CrazyWizard-png/Crazy-75__Custom-Mechanical-Keyboard/README.md

# Crazy-75
The journey of creating my first ever custom mechanical keyboard. 

Check my journal for the newest progress updates.
