CrazyWizard-png/Crazy-75__Custom-Mechanical-Keyboard/images/Pi pico clone pinout.png

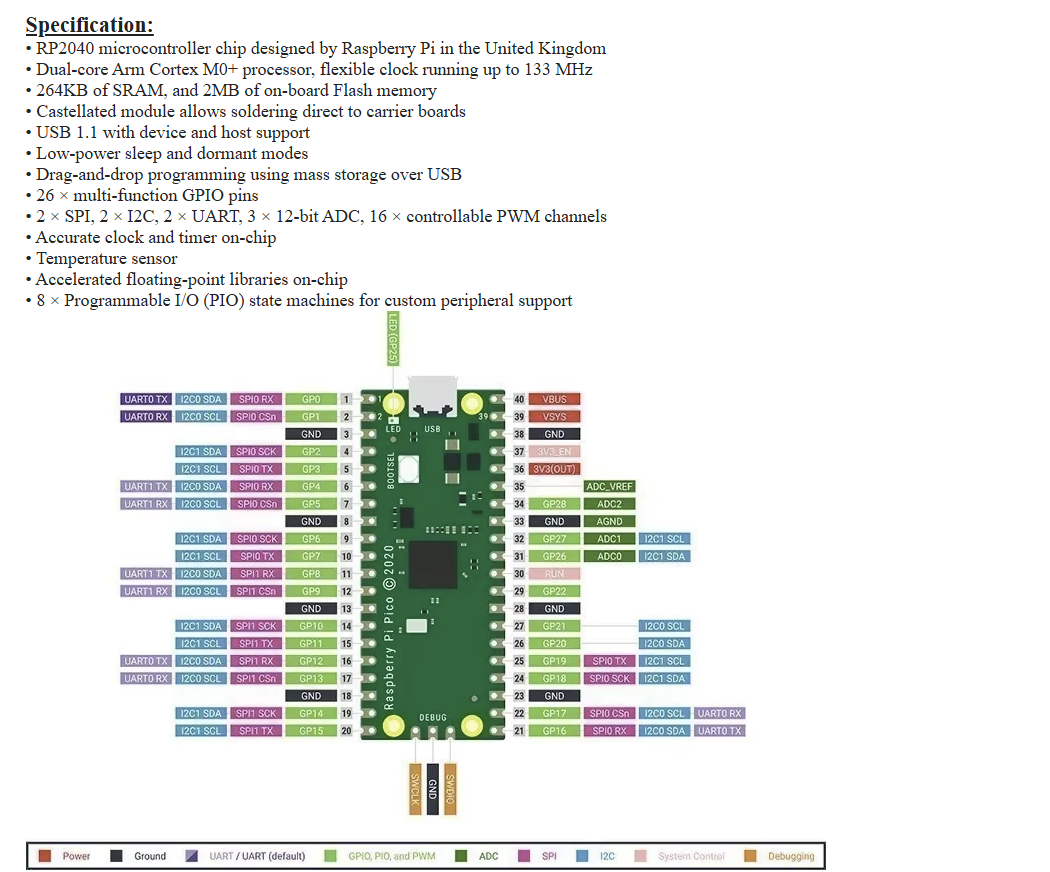
images/Pi pico clone pinout.png
