CrazyWizard-png/Crazy-75__Custom-Mechanical-Keyboard/Keyboard BOM.xlsx

Part No. | Name | Description | Quantity required | Quantity | Total (EURO) | Link | .
1 | Kailh Hot-swappable PCB socket | Kailh style Hot-swappable PCB socket Hot Plug CPG151101S11 for Gateron Outemu Cherry MX Switches Mechanical Keyboard | 78 | 80 | 14.04 | https://42keebs.eu/shop/parts/kailh-mx-hot-swap-sockets/ | .
2 | Switches |  | 78 |  |  |  | .
3 | Keycaps |  | 79 |  |  |  | .
4 | 1N4148 High-speed Switching Diodes |  | 79 | 80 | 1.72 | https://fr.aliexpress.com/item/4001126137167.html?curPageLogUid=NsA9XtVVd8ar (https://42keebs.eu/shop/parts/components/1n4148-diodes-through-hole-smd/?attribute_type=Through-hole) | .
5 | SK6812 MINI-E RGB |  | 80 | 100 | 4.99 | https://fr.aliexpress.com/item/1005007863635868.html?curPageLogUid=OsdDD2ovEBL6 | .
6 | EC11 rotary encoder | 360 Degree Rotary Encoder EC11 With Push Button | 1 | 1 | 1.99 | https://fr.aliexpress.com/item/1005007644083514.html?curPageLogUid=RiI44SzlN0mT | .
7 | Frood RP2040 Pro Micro Controller |  | 1 | 1 | 12.87 | https://42keebs.eu/shop/parts/controllers/frood-rp2040-pro-micro-controller/ | .
8 | Stabilizers | Screw-in scabilizers | 6.25u & 3x2u | 6.25u & 4x2u | 24.07 | https://fr.aliexpress.com/item/1005001632672798.html?curPageLogUid=chUJ3H275Bvb | .
9 |  |  |  |  |  |  | .
10 | Fine tweezers | straight and curved fine tweezers | 1 | 1 | 2.17 | https://fr.aliexpress.com/item/1005005589349988.html?browser_id=2269fcae49994bc495ac18d9a18a9643 | .
11 | USB cable |  |  |  |  |  | .
12 | Quality solder |  |  |  |  |  | .
13 | Poron Gaskets strips | 90x5x2mm | 4 | 5 | 3.91 | https://fr.aliexpress.com/item/1005005793344984.html?curPageLogUid=S7v4FRbEFjS1 | .
14 | Poron gasket PCB switch pads |  | 78 | 120 | 3.21 | https://fr.aliexpress.com/item/1005012165183655.html?curPageLogUid=HxhioEm1eLyc | .
15 | Poron gasket plate pads |  | 78 | 120 | 3.6 | https://fr.aliexpress.com/item/1005011957195138.html?curPageLogUid=zxNyBwnBzLWJ | .
16 | M3 Heat Set inserts | 400pc kit | 8 |  | 10.4 | https://fr.aliexpress.com/item/1005005789416899.html?curPageLogUid=npJ5GAaoLiBK | .
17 | M3 machine screws | Already owned |  |  |  |  | .
18 | Pinecil heat set inserts kit |  |  |  | 32.35 | https://keeb.supply/products/pinecil-threaded-insert-tips-set | .
19 | Self adhesive silicon rubber feet | 10x3mm | 6 | 20 | 3.1 | https://fr.aliexpress.com/item/1005006612644612.html?curPageLogUid=zZGnjd4BE3HC | .
 |  |  |  |  |  |  | .
 |  |  |  |  |  |  | .
 |  |  |  |  |  |  | .
 | Total |  |  |  | 111.61 |  | .
