CrazyWizard-png/Crazy-75__Custom-Mechanical-Keyboard/CAD/Crazy-75 - PCB.step

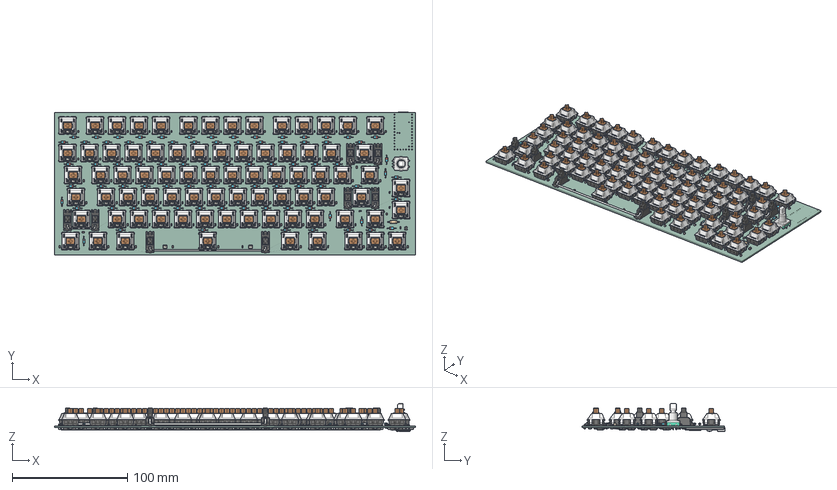
[picture p2: CAD file, 2026-10-01]
CAD/Crazy-75 - PCB.step
313.0 x 123.8 x 24.7 mm
C_0805_2012Metric x 82
D_DO-35_SOD27_P7.62mm_Horizontal x 80
Stabilizer_Cherry_MX_6_25u_cp
SOT-23-5
Stabilizer_Cherry_MX_2u_cp x 3
R_Axial_DIN0207_L63mm_D25mm_P1016mm_Horizontal
EC11N1525404 v3
Contact x 158
SW_Cherry_MX_Plate_cp x 79
LED_SK6812MINI-E v2 x 81
ProMicroRP2040 - 3D v15
Crazy-75_PCB
