CrazyWizard-png/Crazy-75__Custom-Mechanical-Keyboard/PCB/Crazy-75/Crazy-75 - PCB.step

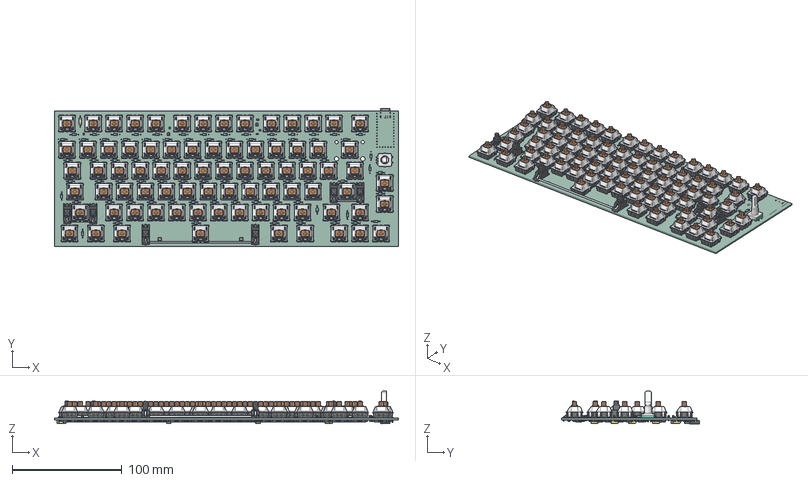
[picture p3: CAD file, 2026-11-01]
PCB/Crazy-75/Crazy-75 - PCB.step
313.0 x 126.0 x 29.6 mm
SOT-23-5
D_DO-35_SOD27_P7.62mm_Horizontal x 80
SOT-23-6 x 3
Stabilizer_Cherry_MX_6_25u_cp
R_0805_2012Metric x 8
Stabilizer_Cherry_MX_2u_cp x 2
C_0805_2012Metric x 85
R_Axial_DIN0207_L63mm_D25mm_P1016mm_Horizontal
(Unsaved)
Contact x 158
SW_Cherry_MX_Plate_cp x 79
LED_SK6812MINI-E v2 x 81
CP_EIA_7343_31_Kemet_D x 9
SOT-23
USB_C_Receptacle_GCT_USB4085
Crazy-75_PCB
