CrazyWizard-png/Crazy-75__Custom-Mechanical-Keyboard/Journal.md

# 1 November 2026 - Updating the USB-C cutout

**Time spent: 1 h**

### What I did

Redid the USB-C cutout in the case CAD model to match the new connector.

### Next step

Start routing the PCB.

---

# 31 October 2026 - Cleaning up the BOM

**Time spent: 1 h 30 min**

### What I did

Finally went through the whole BOM, checked the links, updated prices and compared ordering from AliExpress or 42. Keebs. I had been putting this off for a while because I knew the BOM was a mess.

The hardware currently comes to about **€111**, excluding switches, keycaps and a USB cable. Anything added later will increase that, so hopefully there won't be much left to add since want to keep the costs down.

### Next steps

Redo the USB-C cutout in the case to match the new connector, then start routing the PCB.

---

# 30 October 2026 - PCB component placement

**Time spent: 1 h 15 min**

### What I did

Placed the newly added components in the PCB editor and checked their positions against the case to avoid collisions once everything is assembled.

I caught a few things along the way. The per-key LEDs will be soldered underneath the PCB, but I had placed their SMD capacitors on top. I moved all of those capacitors to the underside too, which should save a lot of unnecessary vias when routing.

I also checked component heights and fixed the silkscreen overlaps that needed attention.

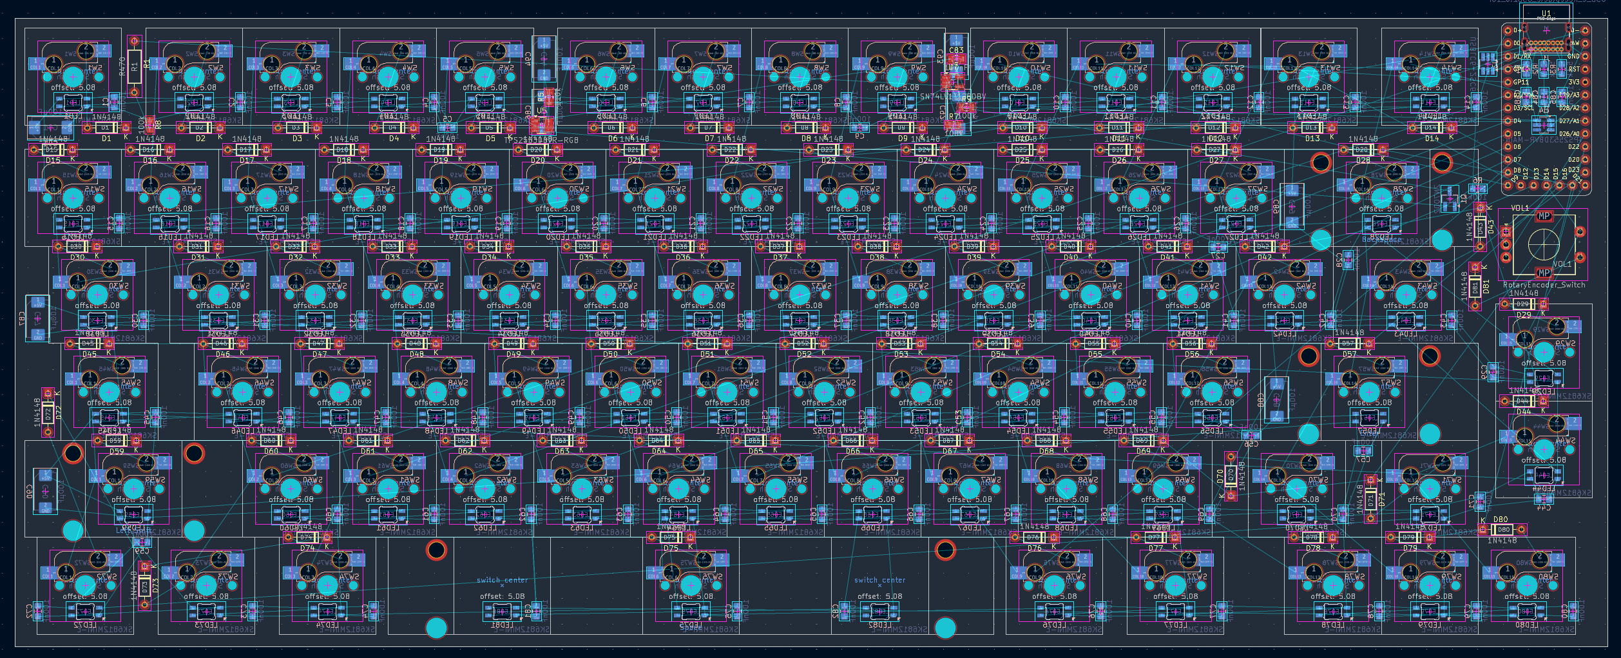
[picture p4: images/PCB-editor_30.10.2026.png]
PCB-editor_30.10.2026

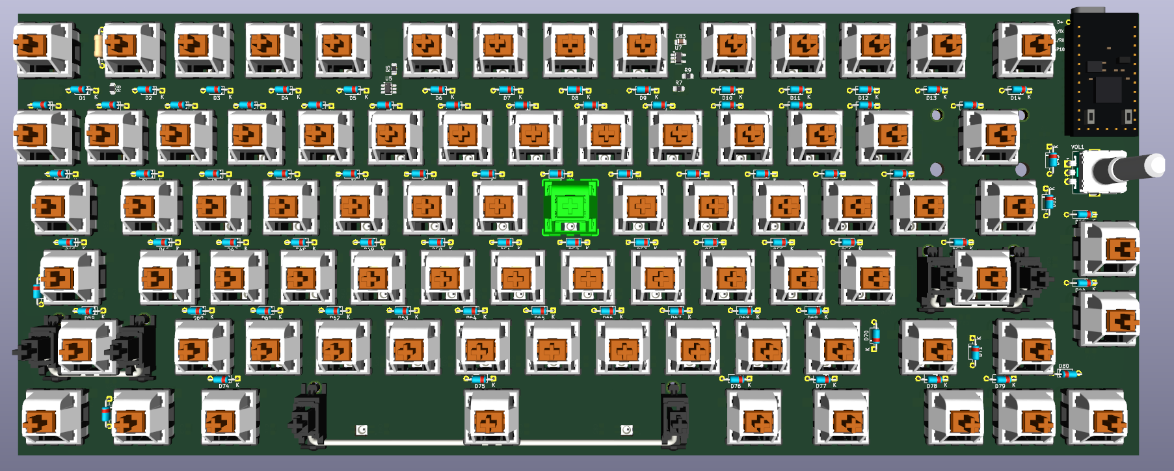
[picture p5: images/PCB-3D-view_front_31.10.2026.png]
PCB-3D-view_front_31.10.2026

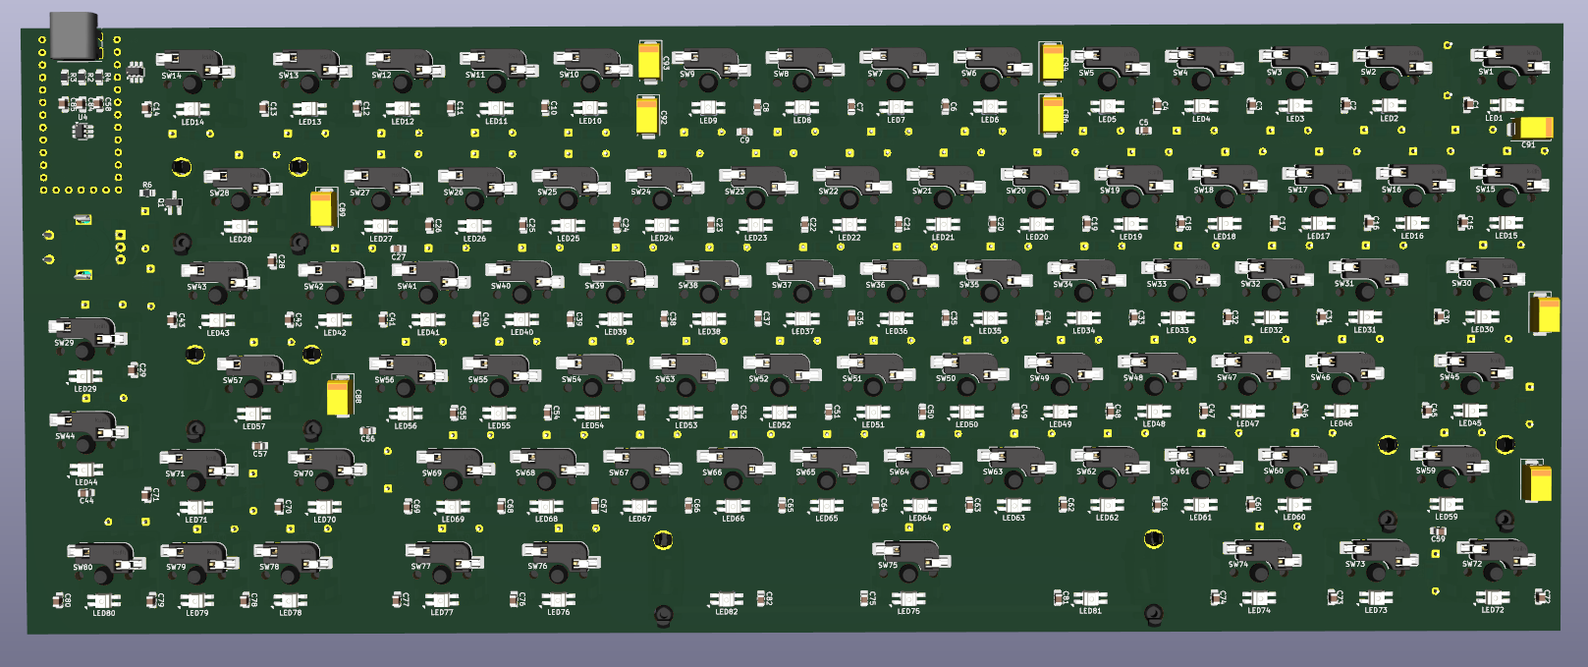
[picture p6: images/PCB-3D-view_back_31.10.2026.png]
PCB-3D-view_back_31.10.2026


---

# 24 October 2026 - Reworking USB and RGB power

**Time spent: 2 h 30 min**

### Schematic changes

Today I added a separate USB-C connector and changed the controller to the **Frood RP2040**. I added USB protection and two current-limited power switches: one for the entire keyboard and one only for the RGB LEDs.

I spent quite a while understanding the circuit instead of just copying setups from the internet. This feels embarrassing since I decided to embark on the journey to create a custom mechanical keyboard from the ground up, but, for example, today I learned the true purpose of Pull-up and pull-down resistors which now finally make more sense, including why the buffer needs a high signal to disable its output.

I decided on a 500 mA power budget which is the the max. current available through conventional USB2.0 ports. And since I only want a gentle glow in the dark, running every LED at full brightness is unnecessary. All the LEDs together could draw several amps, that is why they got their own power limiting switch inside the already power-limited network.

The case has roughly 6 mm underneath the PCB, so I chose low-profile capacitors instead of the tall electrolytic ones. I also selected hand-solder footprints wherever I could, hopefully making life easier for future me.

ERC found no warnings.

#### The reason for this change?

I could not reliably verify the max. current which I could pass through the previously used **TENSTAR RP2040 Pro Micro** and it was bothering me a lot. So I decided to get rid of it and use a module which allows me to install a separate USB-C receptacle and connect the data and power pins to it without having to pass the whole 0.5A through it. 

### Next step

Update the PCB from the schematic, arrange the newly added components and check component placement against the case before routing.

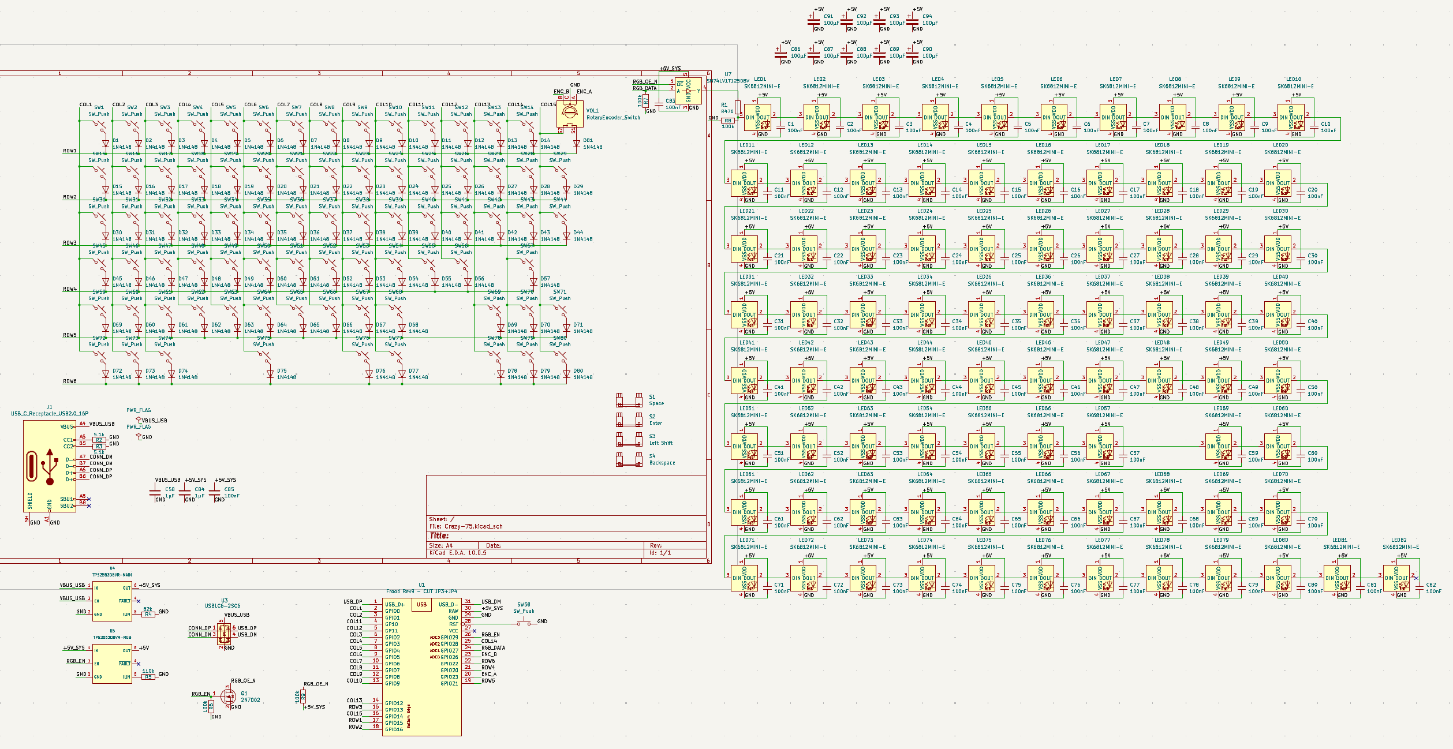
[picture p7: images/24.10.2026_PCB-schematic-rework.png]
PCB-schematic-rework


---

# 10 October 2026 - Preparing for PCB routing

**Time spent: 1 h**

### Researching PCB routing and manufacturing requirements

Today I started preparing for the PCB routing stage of Crazy-75.

Before connecting hundreds of components, I wanted to make sure the PCB design rules were based on actual manufacturing capabilities rather than arbitrary values.

I researched PCBWay's manufacturing specifications, including minimum trace widths, copper clearances, via dimensions, board thickness and copper weight.

I also compared 1 oz and 2 oz copper due to the large amount of LEDs on the board, ultimately leaning towards 1 oz because it offers sufficient flexibility for the densely populated keyboard PCB, provided the power distribution is designed appropriately.

### Configuring KiCad and troubleshooting DRC

I began configuring KiCad's design rules and ran the Design Rules Checker (DRC).

This initially produced numerous copper-to-edge clearance errors around the SK6812 MINI-E RGB LEDs. The reported distances also changed as I adjusted the minimum clearance, which made the problem confusing to diagnose.

After researching PCBWay's manufacturing tolerances, I changed the minimum copper-to-edge clearance to **0.25 mm**, matching their published normal-process specification. This eliminated the reported errors.

### Investigating power limitations

Another important question was how much current the keyboard can safely draw through its **TENSTAR RP2040 Pro Micro 16MB** development board.

With approximately 81 individually addressable RGB LEDs, the power supply could become a significant limitation.

I researched USB power limits and the development board's specifications, but could not find reliable documentation confirming the maximum current that can pass from its USB-C connector to the 5V pin.

I therefore contacted TENSTAR 02 Store by email, requesting information about the maximum continuous output current, USB power-path components, USB-C configuration and any available schematics.

### Investigating autorouting

Given the large number of connections, I also investigated alternatives to manually routing the entire PCB.

I decided to try **Freerouting**, an open-source autorouter compatible with KiCad, and installed its plugin.

The current plan is to use autorouting for most of the switch matrix and signal connections while paying particular attention to the 5V power distribution, grounding and RGB LED circuitry.

### Current state and next steps

The PCB routing rules have been partially configured, the initial DRC errors have been resolved, and Freerouting is installed.

I am now waiting for technical information from two sources:

- **TENSTAR:** USB power-path specifications and safe current limits.
    
- **PCBWay:** Engineering advice on the SLS PA12 switch plate openings and confirmation of manufacturing details.

**Next step:** Test Freerouting on a separate copy of the PCB, evaluate the resulting connections and continue refining the design rules as the manufacturers provide more information.

_Time spent watching KiCad tutorials on YouTube is not included in the recorded hour._

---

# 9 October 2026 - Finishing the functional case design

**Time spent: 1 h 30 min**

### Finishing the case mounting system

Today I completed the remaining functional details of the Crazy-75 enclosure.

I added the mounting holes for the screws connecting the top and bottom case halves. The design uses eight screw positions, with M3 heat-set inserts planned for the top case. These will allow the case to be opened repeatedly without wearing out threads in the printed plastic.

I also added six locations for adhesive rubber feet on the underside of the case, arranged in two rows of three to provide stable support across the keyboard.

### More Fusion problems

Fusion caused further problems today. When attempting to launch it, I was presented with several error messages, and the application would not start properly.

Restarting the computer did not resolve the issue, and Fusion continued behaving as though parts of the program were still running.

I eventually had to reinstall Fusion to get it working again.

This added more troubleshooting to a project that has already experienced several CAD software problems.

### Current state

The **functional case design is now complete**, including:

- Two-piece enclosure with a 5° typing angle
    
- Openings for the switches and rotary encoder
    
- Gasket mounting geometry
    
- Clearance for the PCB and its components
    
- USB-C access
    
- Eight case screw positions
    
- Six rubber feet locations

I am still waiting for PCBWay's engineering team to recommend suitable dimensional compensation for the 14 × 14 mm switch openings in the SLS PA12 plate.

I have not decided whether to add further aesthetic details to the case. For now, I am satisfied with the functional geometry and would rather continue with the electronics than spend additional time changing its appearance without a clear goal.

**Next step:** Begin routing the PCB in KiCad, followed by electrical and manufacturing checks.

---

# 2 October 2026 - Designing the bottom case

**Time spent: 1 h**

### Starting the bottom enclosure

Today I designed the first functional version of the bottom half of the Crazy-75 case.

Unlike the flat top case, the bottom enclosure is wedge-shaped to create the keyboard's typing angle. I used a **5° typing angle**, making the enclosure progressively taller towards the rear while keeping the top and plate assembly aligned.

I built the bottom around the existing top-case and PCB assembly rather than designing it independently. This made it possible to check the actual space required underneath the PCB and its components.

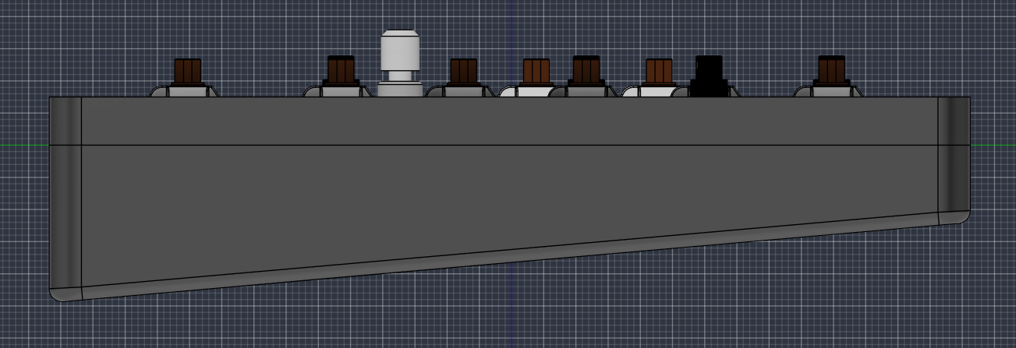
[picture p8: images/Case-bottom-side.png]
Bottom case side view


### Internal clearance and USB-C

The enclosure was sized around the lowest components underneath the PCB while leaving additional clearance between the electronics and the case floor.

I also added the opening for the RP2040's USB-C connector. Moving the controller to the underside and edge of the PCB earlier made this considerably simpler, since the connector can now be accessed directly through the rear of the enclosure.

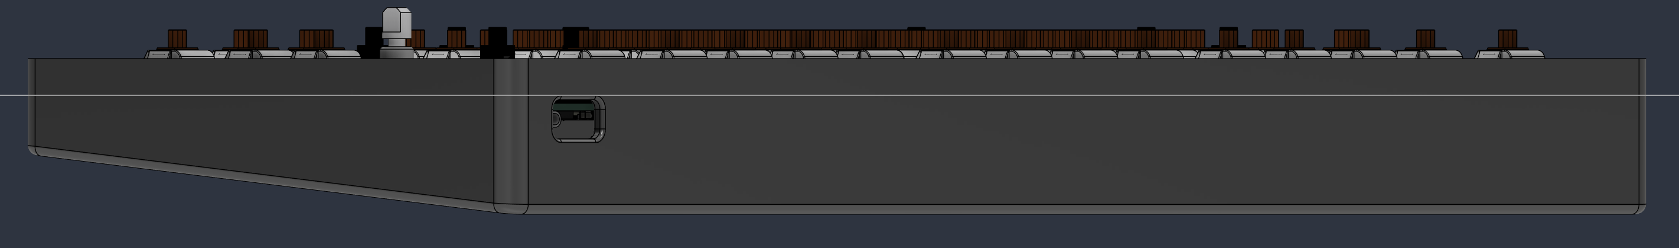
[picture p9: images/Case_bottom-USB-C.png]
USB-C opening


### Fusion problems

A significant part of today's work was spent dealing with Fusion rather than making visible CAD progress.

Some existing components and geometry would not project correctly into new sketches, which made referencing the already completed parts more difficult than expected.

I also had problems with Fusion's cloud/project memory not synchronizing correctly. This caused additional time to be spent checking the model and working around geometry which Fusion was not referencing as expected.

Despite these problems, I was able to finish the basic bottom-case geometry.

### Current state

The Crazy-75 now has both a top and bottom enclosure in CAD.

The bottom case provides the **5° typing angle**, encloses the PCB and underside components, and provides access to the USB-C connector.

The remaining functional case work is mainly the fastening system which will hold the top and bottom halves together. After that, the case should be sufficiently complete to move back to the PCB and begin routing it.

---

# 1 October 2026 - Starting the top case

**Time spent: 2 h**

### Designing the first case part

Today I started designing the actual Crazy-75 case around the plate and PCB assembly.

I decided to split the case into a flat top section and a bottom section which will later create the keyboard's typing angle. This allows the top case to be designed directly around the existing flat plate while leaving the more complicated inclined geometry for the bottom case.

Rather than creating individual openings around every switch, I used one large opening around the main key area. A separate area was kept around the rotary encoder for aesthetics.

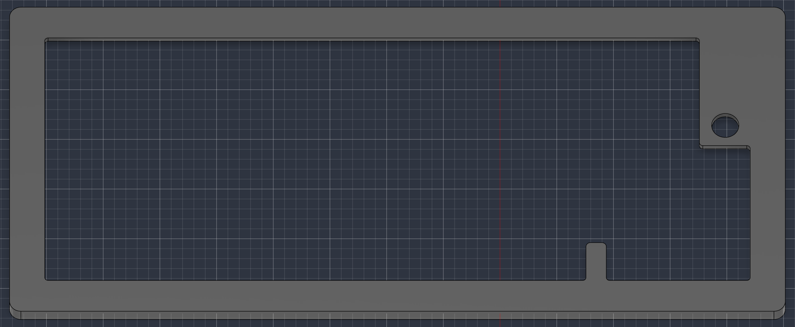
[picture p10: images/Top_case_top-down.png]
Top case


### Plate clearance

I based the internal shape of the top case directly on the existing plate geometry.

I left approximately **0.5 mm nominal clearance between the plate and the rigid top case** around its perimeter. This is important because the plate should eventually be supported through the PORON gaskets rather than resting directly against the case.

The irregular sections of the plate, including the gasket mounting ears and the area around the rotary encoder, were accounted for when creating the opening.

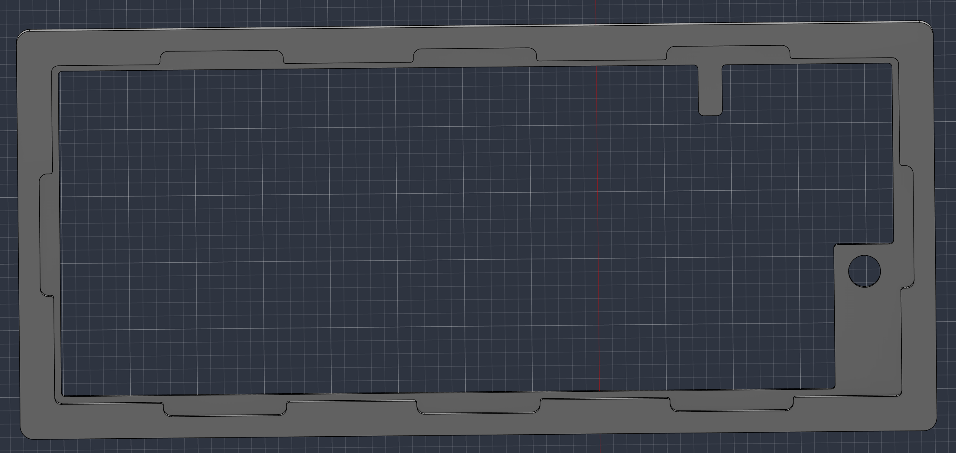
[picture p11: images/Top_case_bottom.png]
Top case bottom


### Gasket mounting

The top case was also designed around the eight gasket locations already present on the plate:

- 3 along the front
- 3 along the rear
- 1 on the left
- 1 on the right

The current plan is to use **45 × 5 × 2 mm PORON gasket strips** at these locations.

The plate and top case geometry now leave the necessary space around these gasket ears so that the plate can eventually be suspended between PORON rather than making rigid contact with the case.

### Checking the assembly

I placed the new top-case geometry together with the existing plate, switches, stabilizers, encoder and PCB assembly in Fusion and visually checked their alignment.

The large opening exposes the switches while the top case surrounds the complete assembly and follows the plate geometry without touching it.

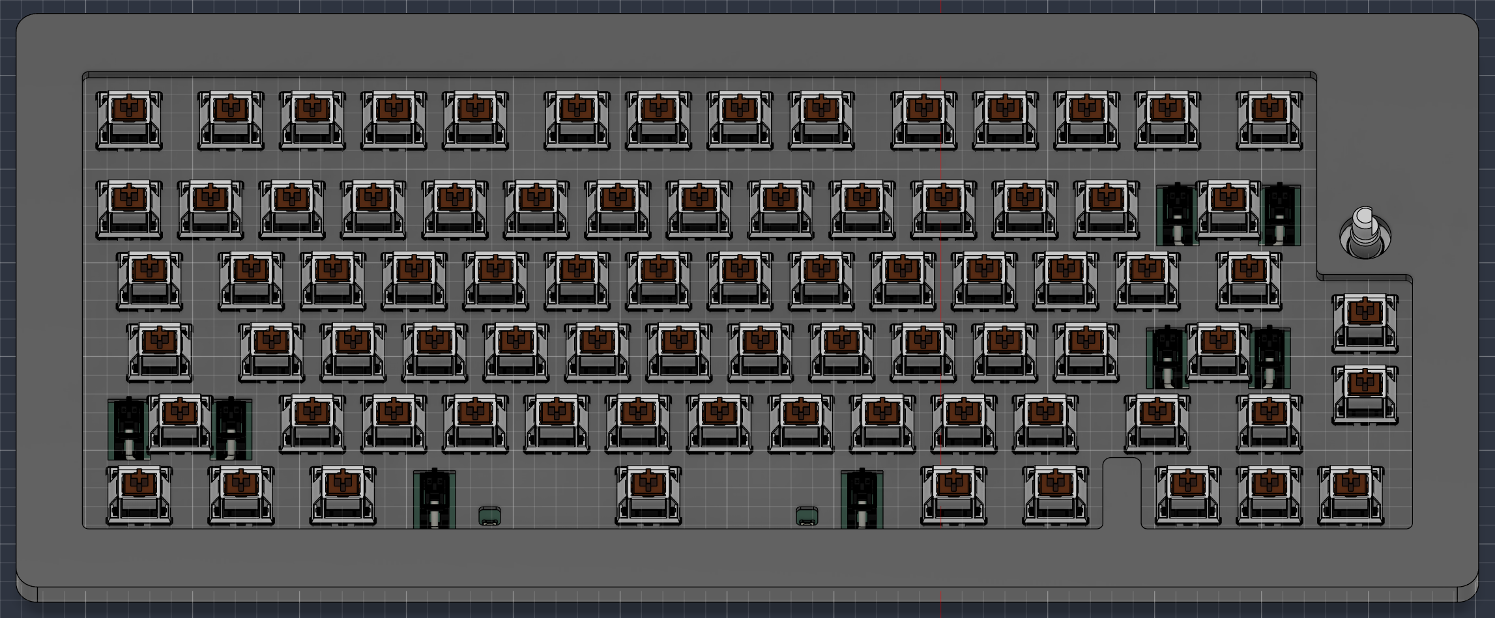
[picture p12: images/Top_case_assembly.png]
Top case assembly


### Current state

The first functional version of the **top half of the Crazy-75 case** now exists.

The bottom case will need to account for:

- the lower gasket supports
- PCB and component clearance
- the RP2040 and USB-C connector
- case screws
- the keyboard's typing angle

---

# 26 September 2026 - Finishing the plate + RP2040 board placement rework

**Time spent: 2 h**

### Finishing the plate

I returned to the plate and added the remaining functional openings.

This took approximately 20 minutes and included:

- clearance cutouts for all four PCB-mounted stabilizers
- two additional openings for the extra LEDs underneath the Spacebar

Because the stabilizers are attached to the PCB rather than the plate, these openings only need to provide sufficient mechanical clearance around their housings.

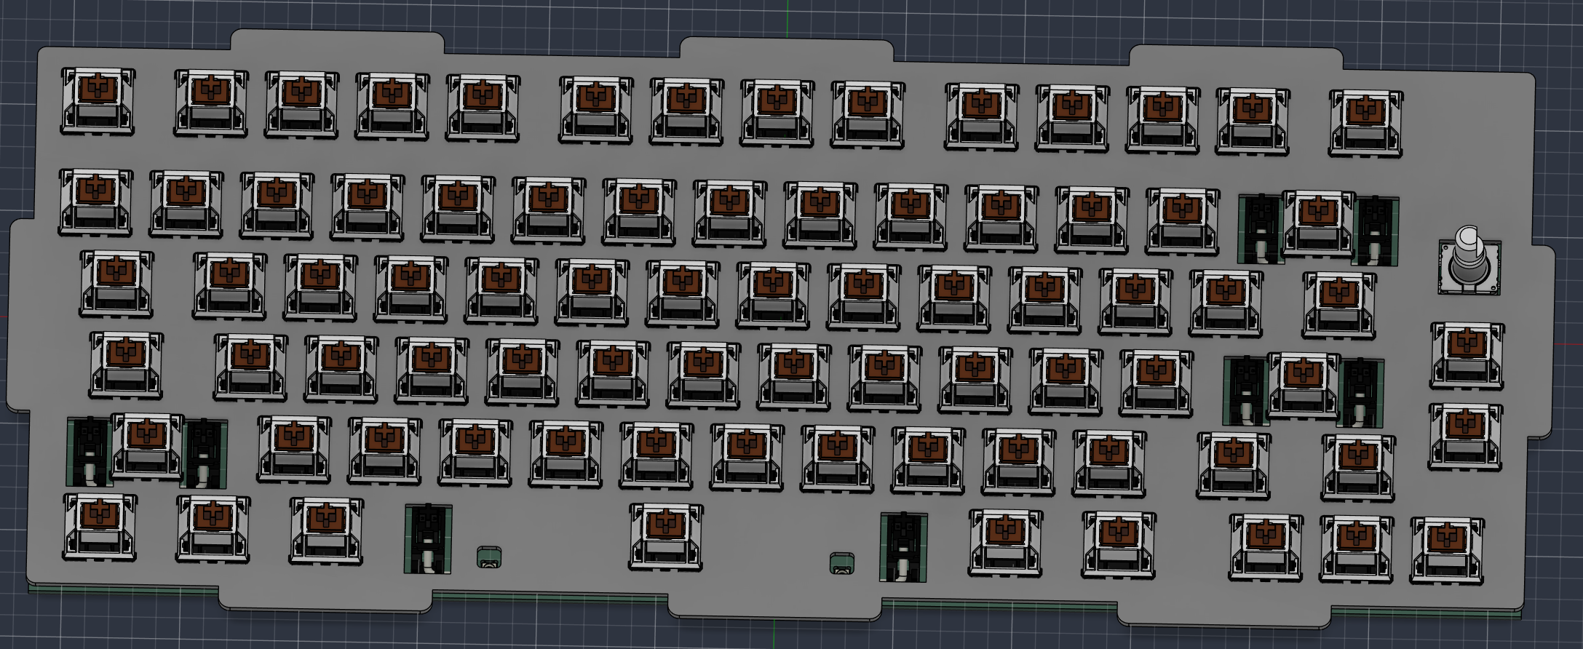
[picture p13: images/26.09.2026-Plate-1.png]
26.09.2026-Plate-1


### Reconsidering the RP2040 mounting

While beginning to think about the actual case around the completed PCB/plate assembly, I realized that the existing RP2040 mounting arrangement created an awkward USB-C problem.

The controller was previously positioned on top of the PCB and intended to be raised using female socket headers. This would require the USB-C cable to reach underneath the raised controller and through a relatively large opening in the case.

The planned keyboard incline would make this worse because the main PCB, and therefore the raised controller, would also be inclined. The USB-C connector would consequently end up unnecessarily high on the rear of the keyboard.

I looked again at other keyboard designs, particularly **siderakb/facade**, which uses a separate controller/USB daughterboard. This is mechanically elegant because the USB connector does not have to follow the position and angle of the main keyboard PCB. Though in this case, it would require a big redesign of the PCB and the project has been moving slowly lately anyway. 

So rather than adding another PCB to Crazy-75 at this stage, I tried solving the same problem with the existing RP2040 module.

### Moving the controller underneath the PCB

I flipped the **TENSTAR RP2040 Pro Micro 16 MB** module to the underside of the main PCB and moved it much closer to the PCB edge.

The USB-C connector now barely clears the edge of the main PCB, meaning the cable should be able to connect directly behind the rear case wall instead of traveling deep into the construction.

The closest exposed copper around the RP2040 through-hole pads is approximately 0.5 mm from the PCB edge, which is as close as I would like to get.

I checked PCBWay's manufacturing requirements afterwards. Their published standard CNC-routed copper-to-board-edge capability is 0.25 mm, while they recommend at least 0.5 mm between a drilled hole and the board outline. The current geometry therefore appears to clear the bar.

### Updating and validating the mechanical assembly

Moving the controller changed the physical envelope of the PCB, so I updated the plate design around its new position, simultaneously realising that I had forgotten to add a big cutout to the plate when the controller was still ment to go on top of the PCB.

I then inspected the complete PCB, switches, stabilizers, encoder and plate assembly in Fusion using the **cross-section analysis tool**.

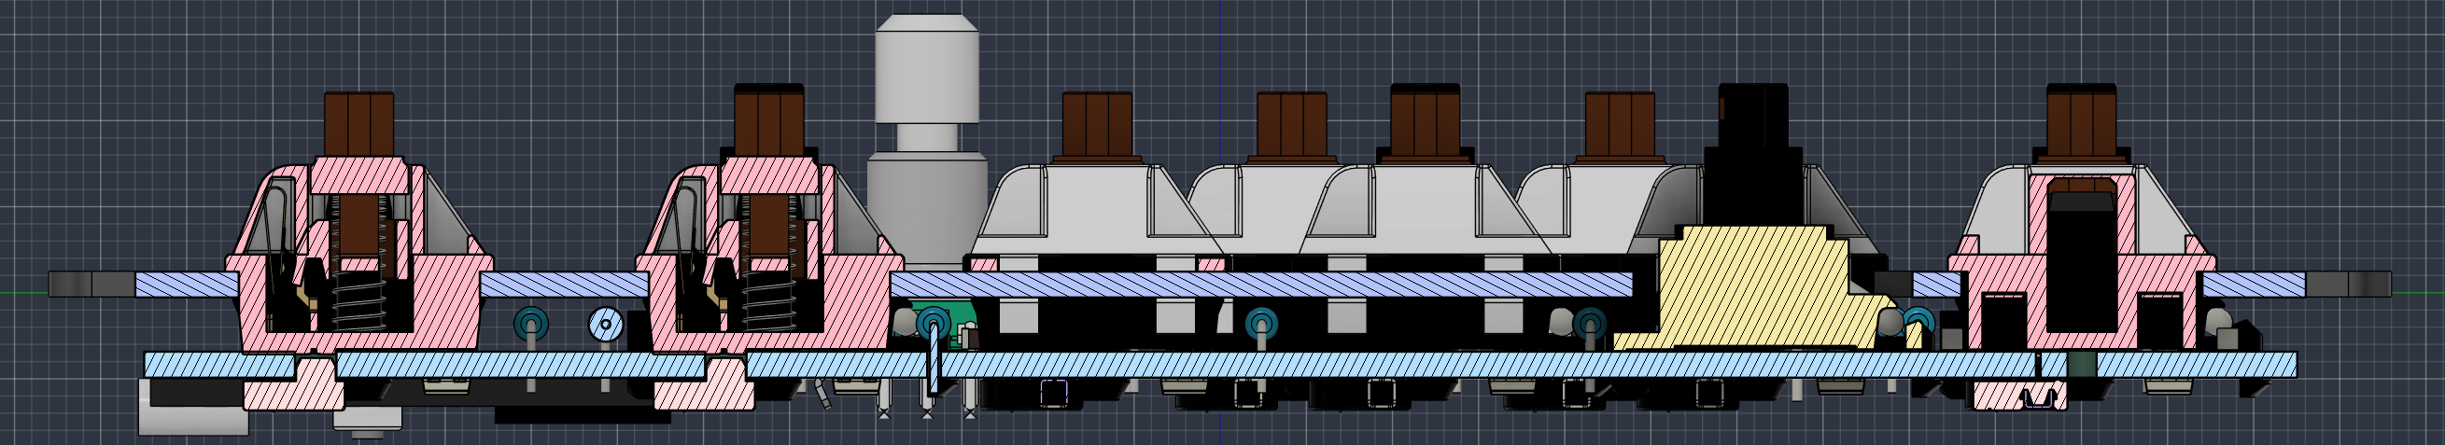
[picture p14: images/26.09.2026_CAD_cross-section.png]
26.09.2026_CAD_cross-section


This made it possible to inspect the assembly internally rather than relying only on exterior views. I checked the changed controller area and the rest of the plate for obvious physical collisions.

No major collision was found in the current arrangement.

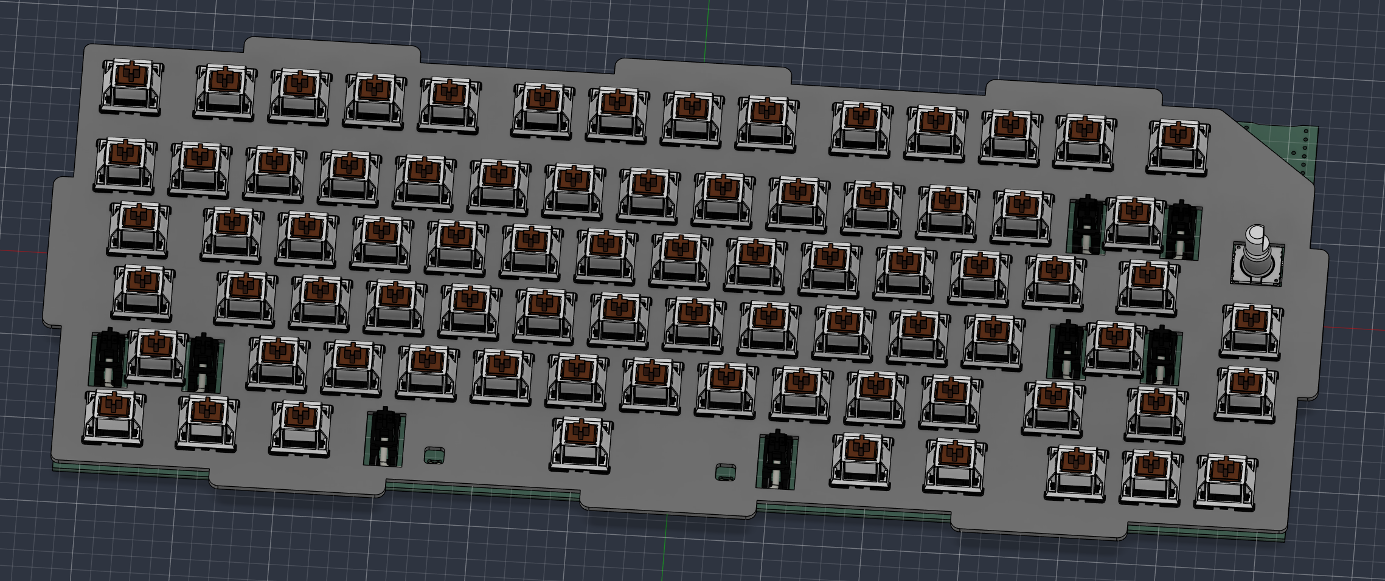
[picture p15: images/26.09.2026_plate-2.png]
26.09.2026_plate-2


### Current state

The Crazy-75 plate is now functionally complete and has been checked against the complete PCB assembly.

The RP2040 arrangement is also considerably cleaner mechanically than before, since the controller is closer to the edge making the USB-C port more accessible.

The next mechanical task is designing the actual gasket-mounted case around the completed plate and PCB assembly.

---

# 24 September 2026 - Designing the switch plate

**Time spent: 1 h 30 min**

### Starting the plate design

Today I started turning the mechanical research from the previous session into the first actual part of the Crazy-75 case assembly.

I exported the PCB assembly .step model and the exact switch positions from KiCad into a CSV file and used them to generate the switch openings in Fusion. This allowed the plate to be based directly on the PCB layout instead of manually recreating the keyboard geometry.

The plate currently uses **14 × 14 mm MX switch cutouts** and a nominal thickness of **1.5 mm**.

### Gasket mounting

I added eight gasket mounting ears around the plate:

- 3 along the front
- 3 along the rear
- 1 on the left
- 1 on the right

After researching commercially available gasket material, I decided not to make the keyboard dependent on proprietary AEBoards gasket strips. Instead, the current plan is to use generic **5 mm wide PORON strips**, which are considerably easier and cheaper to source.

The gasket ears were rounded rather than leaving sharp rectangular corners.

### Mechanical openings

I also added the opening for the rotary encoder.

The plate is not completely finished yet. It is still missing clearance around the four PCB-mounted stabilizers and openings for the two additional LEDs underneath the Spacebar.

The stabilizer product listing was somewhat contradictory about whether the stabilizers were plate-mounted or PCB-mounted. Looking at the actual product photographs confirmed that they are **PCB-mounted screw-in stabilizers**, matching the stabilizer footprints already used in the PCB design.

This means the plate does not locate or hold the stabilizers itself; it only needs enough clearance for the stabilizer housings to pass through.

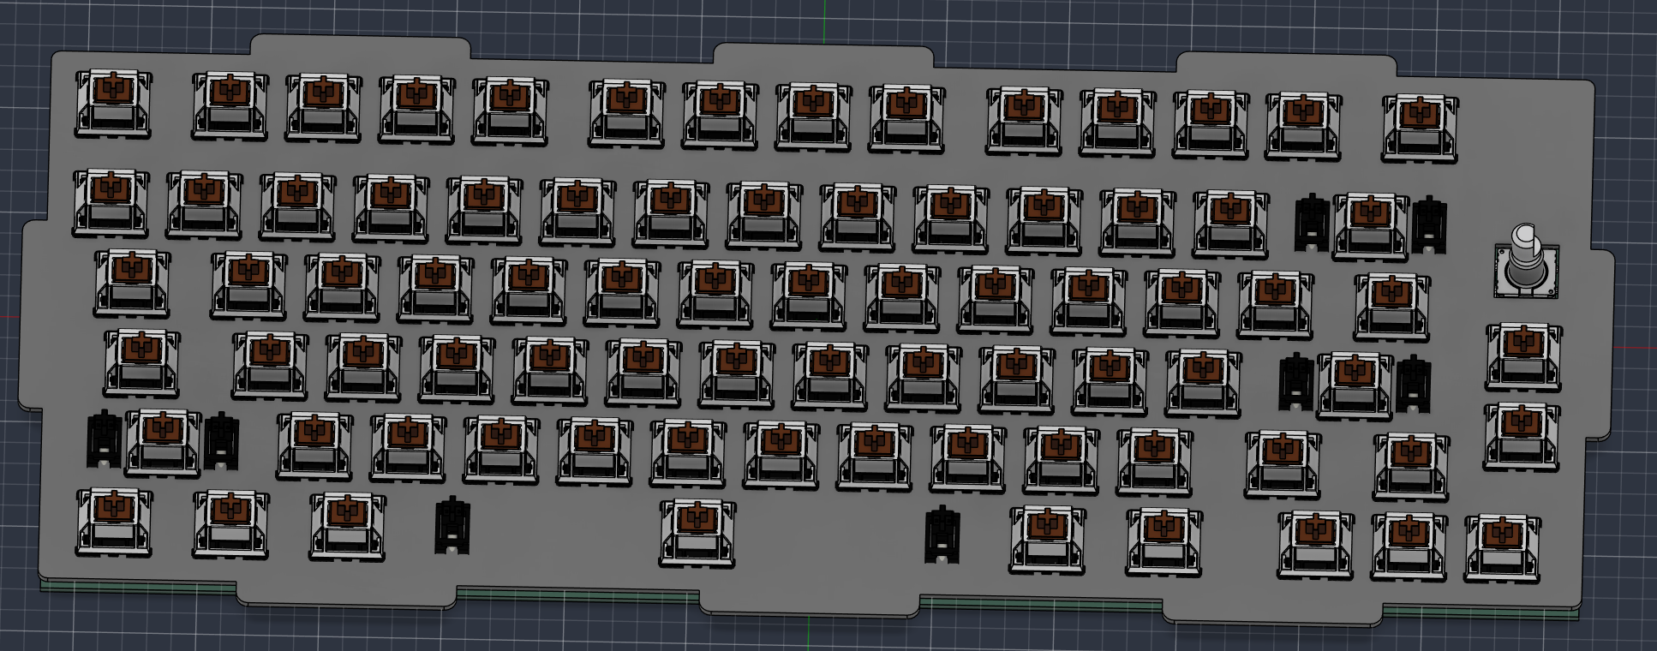
[picture p16: images/24.09.2026-Plate.png]
24.09.2026 Plate


### Current state

The first functional Crazy-75 plate now exists in CAD and aligns with the actual PCB/switch layout.

The remaining work before considering the plate complete is:

- add stabilizer clearance cutouts
- add the two additional Spacebar LED openings
- perform a final mechanical clearance check against the complete PCB assembly

---

# 16 September 2026 - Mechanical design research

**Time spent: 1 h 30 min** 

Researched gasket-mount construction, plate thickness and materials, PCBWay additive and subtractive manufacturing processes, manufacturing tolerances, MX switch cutout dimensions, preliminary case dimensions, and the feasibility/cost of a dedicated fit-test coupon. Used the findings to establish initial parameters for the Crazy-75 plate and case.

# 14 September 2026

**Time spent: 2 h**

### 3D visualization and mechanical validation

I continued preparing the Crazy-75 PCB for the transition from PCB design into mechanical/case design.

Added missing 3D models to the KiCad board so that the physical assembly can be inspected much more realistically. Models were added for:

- MX switches
- stabilizers
- EC11 rotary encoder

Keycap models were also considered but ultimately abandoned. Adding and aligning all of the different keycap sizes would require significant work while providing little additional value for checking the actual PCB.

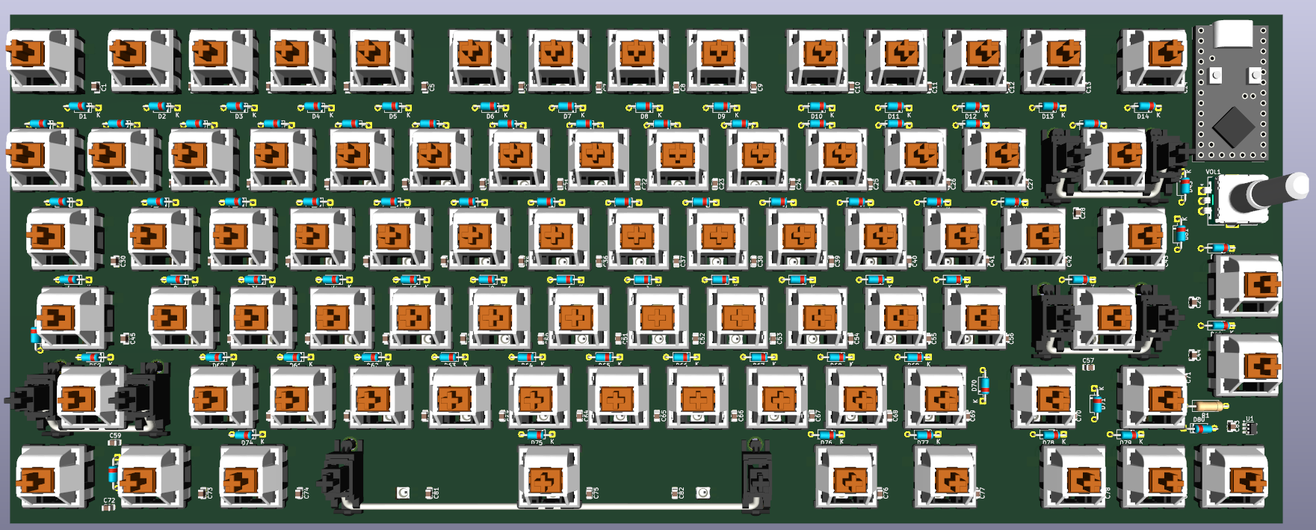
[picture p17: images/Complete-PCB-3D-view.png]
Complete-PCB-3D-view


### Another useful catch from the 3D Viewer

The completed 3D visualization once again proved useful beyond simply making the project look good.

With the physical components visible, I noticed another collision as well as several components near the PCB edge that looked poorly positioned, so I adjusted their placement before moving on. 

This reinforces one of the lessons from the previous session: a PCB layout that appears fine in the 2D editor can still contain mechanical problems that become obvious once the real component geometry is visualized. This time it was due to the 3D visualization revealing what I did not immediately spot looking at the cluttered PCB designer view.

### Gasket-mount research

I Started researching the case and mounting system before beginning PCB routing.

In search of understanding what a gasket-mount design looks like, I looked at several existing open-source gasket-mounted keyboard designs, particularly **hyhenry/Generic65** and **siderakb/facade**, which provide useful CAD files for studying how a complete gasket-mounted keyboard is constructed.

Looking at real designs finally clarified the construction of a plate gasket mount:

- the switches clip directly into the plate
- the PCB hangs underneath and is mechanically connected through the switches
- the plate carries the typing forces
- gasket material sits between the plate and case
- the gasket isolates the plate/PCB assembly from the rigid case and provides controlled compression and movement

This means that **PCB mounting holes are not required for the intended plate-gasket mounting system**. Case mounting and PCB/plate mounting can be treated separately.

This crossection from **siderakb/facade** specifically helped me a lot in understanding gasket-mounted case designs:

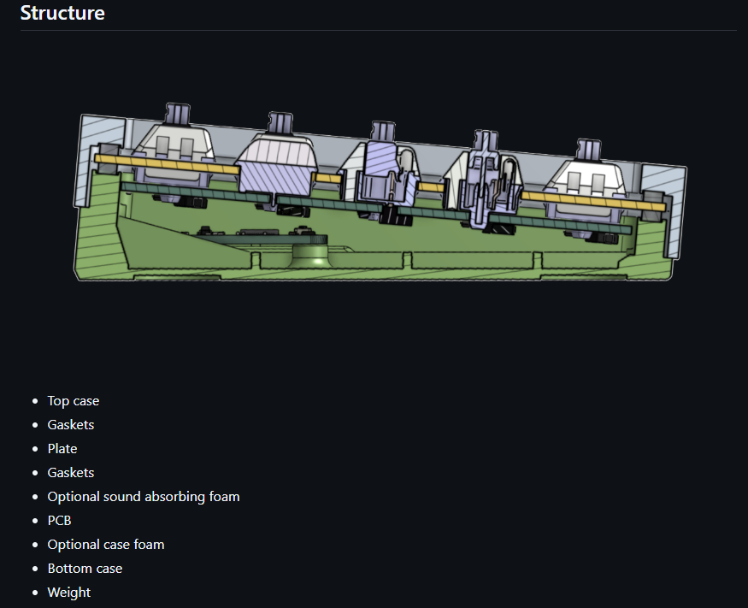
[picture p18: images/Gasket-mount_crossection.png]
Gasket-mount_crossection


### Journal fix

I also went through the journal on Github and spotted several images not being found even tho they all loaded in Obsidian, the not-taking app I use for writing this journal. After checking where the images live, I realised that I forgot to add **images/** before the image names. For some reason Obsidian did not care. So another lesson learned, always check the uploads on Github itself.

### Current state

The PCB component placement is now effectively complete and has been inspected in 3D. Before committing to routing, the next stage will be designing the switch plate and basic gasket-mounted case. Once the mechanical constraints and gasket locations are established, PCB routing can begin without risking major mechanical changes afterward.

---

# 13 September 2026 - PCB Mechanical Checks & 3D Validation

**Time spent: 1 h 30 min**

Continued working on the physical PCB layout and checking whether the component arrangement would actually work mechanically.

## RP2040 placement and PCB outline

I spent time finding a practical position for the new **TENSTAR RP2040 Pro Micro 16 MB** module. Its USB-C connector created an important constraint: placing the module completely flush against the keyboard PCB would place solder pads for the first pins very close to the edge while soldering the module directly to the PCB further back would make the port unusable.

The current best solution I could come up with is to mount the RP2040 using **female socket headers / spacers**, which I then added to the BOM, raising the module above the keyboard PCB. This should provide enough room for the USB-C connector while also making the controller replaceable instead of permanently soldering it directly to the PCB.

The PCB was also finally given its **Edge.Cuts outline**, using approximately **3 mm clearance around the outer keys**. According to what I have read, that is a safe number while not adding to much unnecessary slack.

## Considering PCB flex cuts

I also looked into **PCB flex cuts** after remembering seeing them used in custom mechanical keyboards in a 3 years old LTT video I once watched to provide a "softer bottom-out feel without the mushiness of a membrane keyboard".

After looking at the completed component arrangement, there is very little convenient empty space for meaningful flex cuts. Adding them now would complicate routing considerably and require a lot of component repositioning, so the idea will probably be dropped. Flexibility can instead be considered later through the plate material and case mounting system.

## 3D Viewer checks

I opened KiCad's **3D Viewer**, initially mostly out of curiosity, and it turned into a surprisingly useful mechanical sanity check.

The viewer revealed that the **hotswap socket footprints were on the wrong side of the PCB**. The footprints, including their pads, were flipped to the back side so the sockets now sit underneath the PCB as intended.

This lead to a clearance issue between a hotswap socket pad and its nearby diode. The diode placement was adjusted to provide safer clearance.

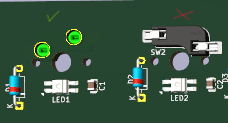
[picture p19: images/Correct_hot-swap_socket_placement.png]
Correct_hot-swap_socket_placement


The 3D Viewer then revealed a second important mistake: the **SK6812 MINI-E LEDs were also mounted on the wrong side**. Since these are reverse-mount LEDs intended to shine through their PCB opening toward the switch/keycap, they were flipped to the correct side as well.

The diode and capacitor positions around the switches were consequently adjusted again. The top-row diodes received additional manual positioning where necessary.

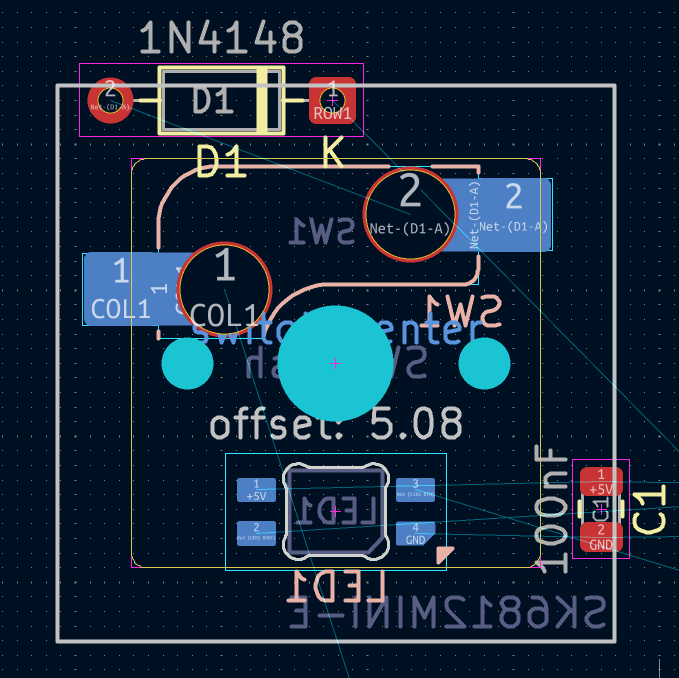
[picture p20: images/Individual-switch-arrangement.png]
Individual-switch-arrangement


After these corrections, the 3D model finally looks mechanically sensible.

This was an important reminder that a PCB can look perfectly reasonable in the 2D editor while still containing a physical assembly mistake. **Checking the board in the 3D Viewer caught errors that could otherwise have resulted in an unusable manufactured PCB.**

## Next step

- Routing

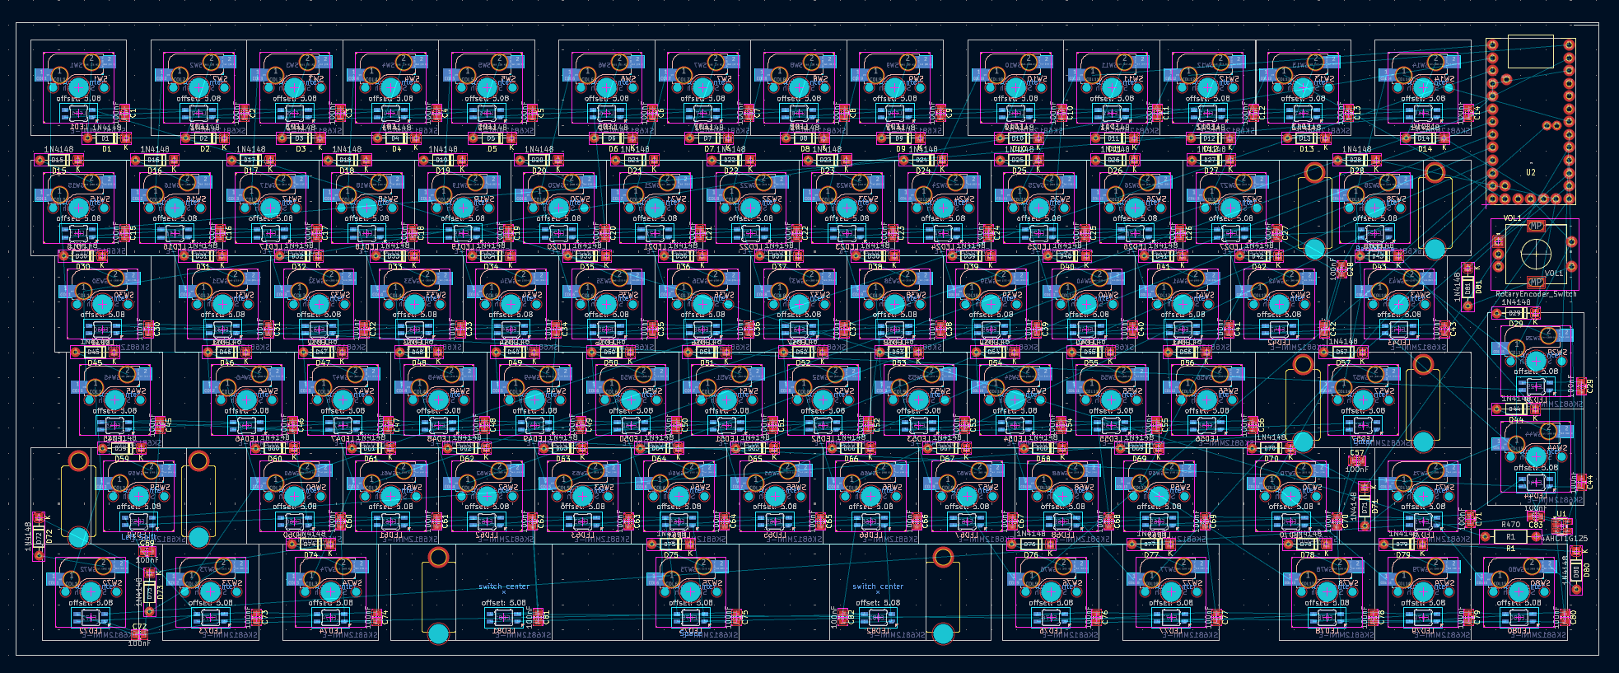
[picture p21: images/13-09-2026_Finished-component-arrangement.png]
13-09-2026_Finished-component-arrangement


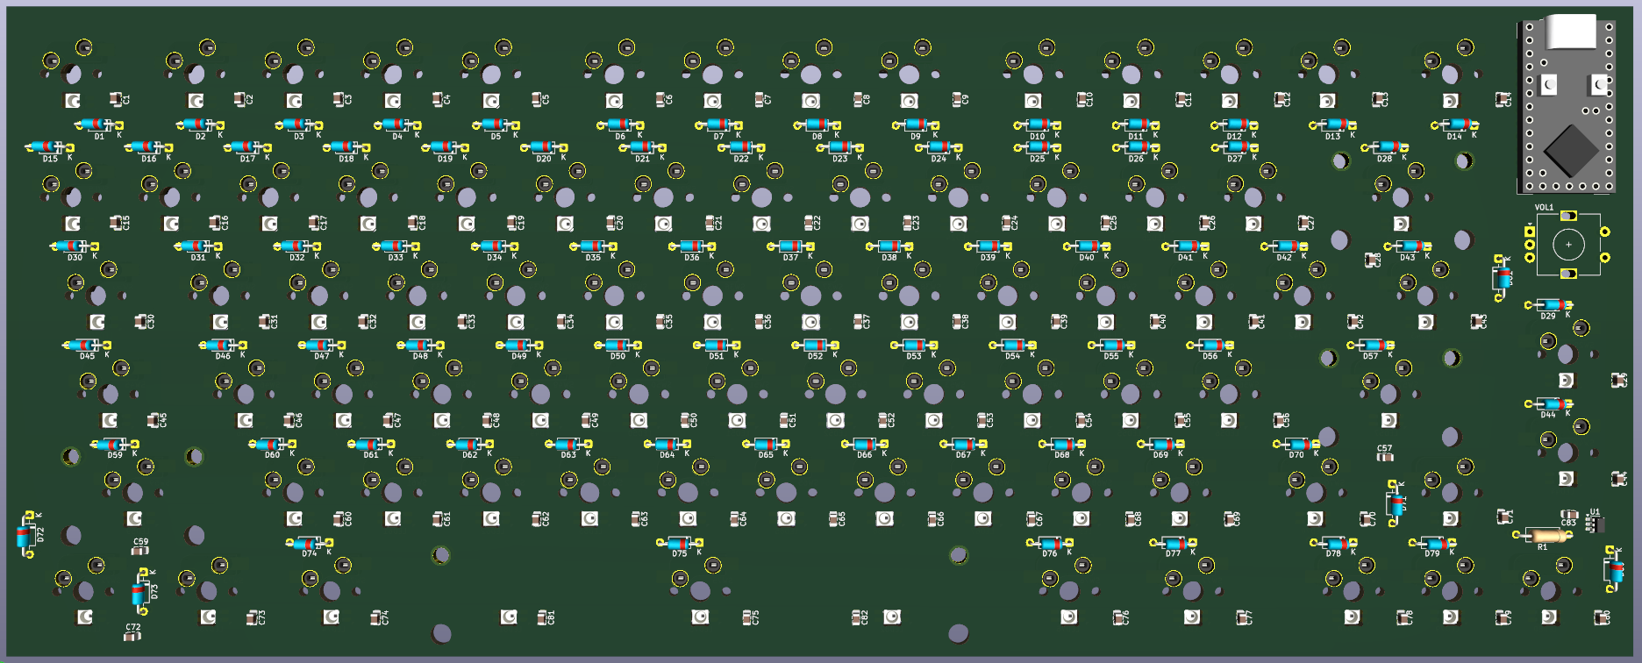
[picture p22: images/PCB-3D-viewer-Front.png]
PCB-3D-viewer-Front


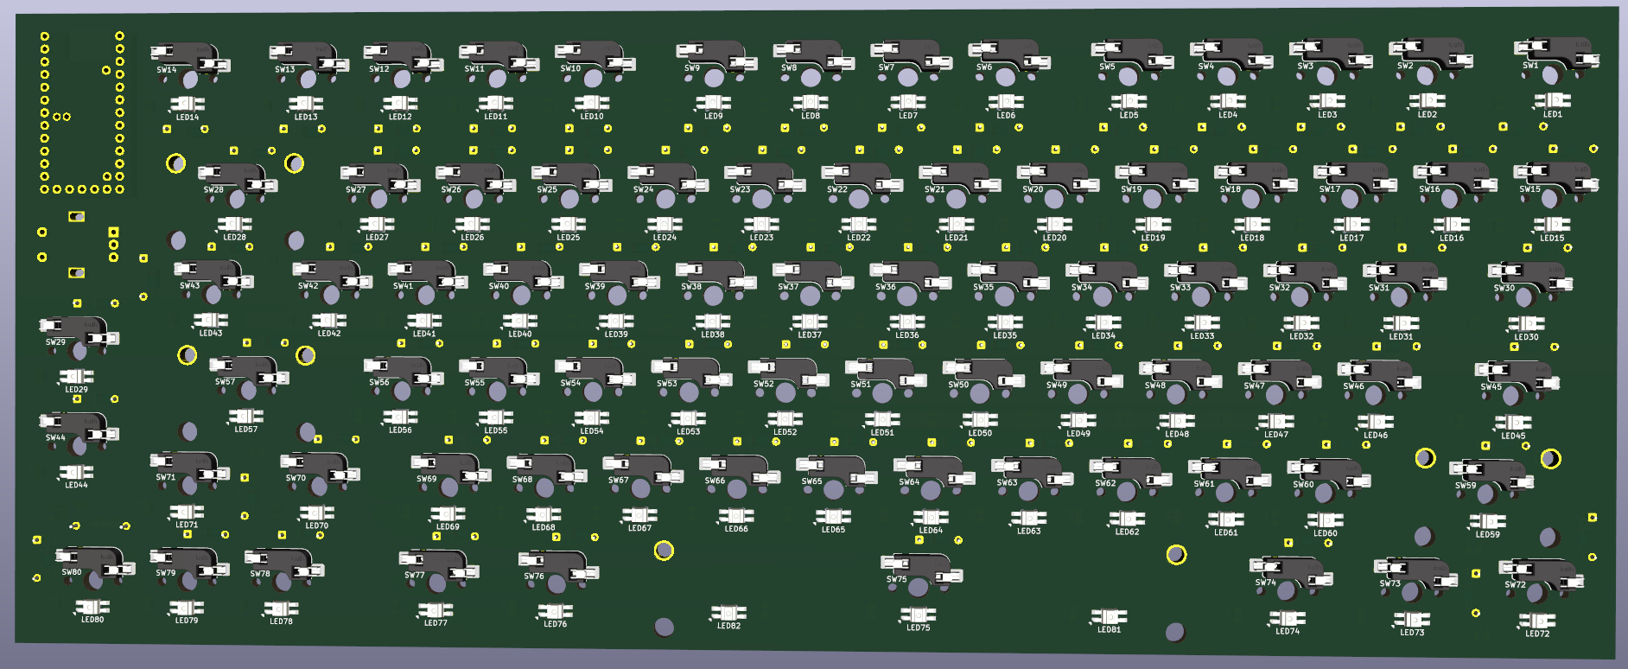
[picture p23: images/PCB-3D-viewer-Back.png]
PCB-3D-viewer-Back


---

# 11 September 2026

**Time spent: 2 h 30 min**

Today I finished the component placement for the PCB and made several changes to the electronics and BOM.

## Microcontroller change

I replaced the full-size Raspberry Pi Pico with a much smaller **TENSTAR RP2040 Pro Micro Development Board (16 MB)**.

The Pico was difficult to integrate into the keyboard without either making the PCB wider or reserving a large empty area for it. The Pro Micro-sized RP2040 board is only around 33 × 18 mm and is much easier to fit into the existing layout while still providing enough GPIO for the keyboard. 

I got the appropriate symbol and footprint from `rroels/kicad_pro_micro_rp2040`.

The unnecessary **M1 key was removed** because it still did not fit comfortably and I did not see much practical use for it anyway.

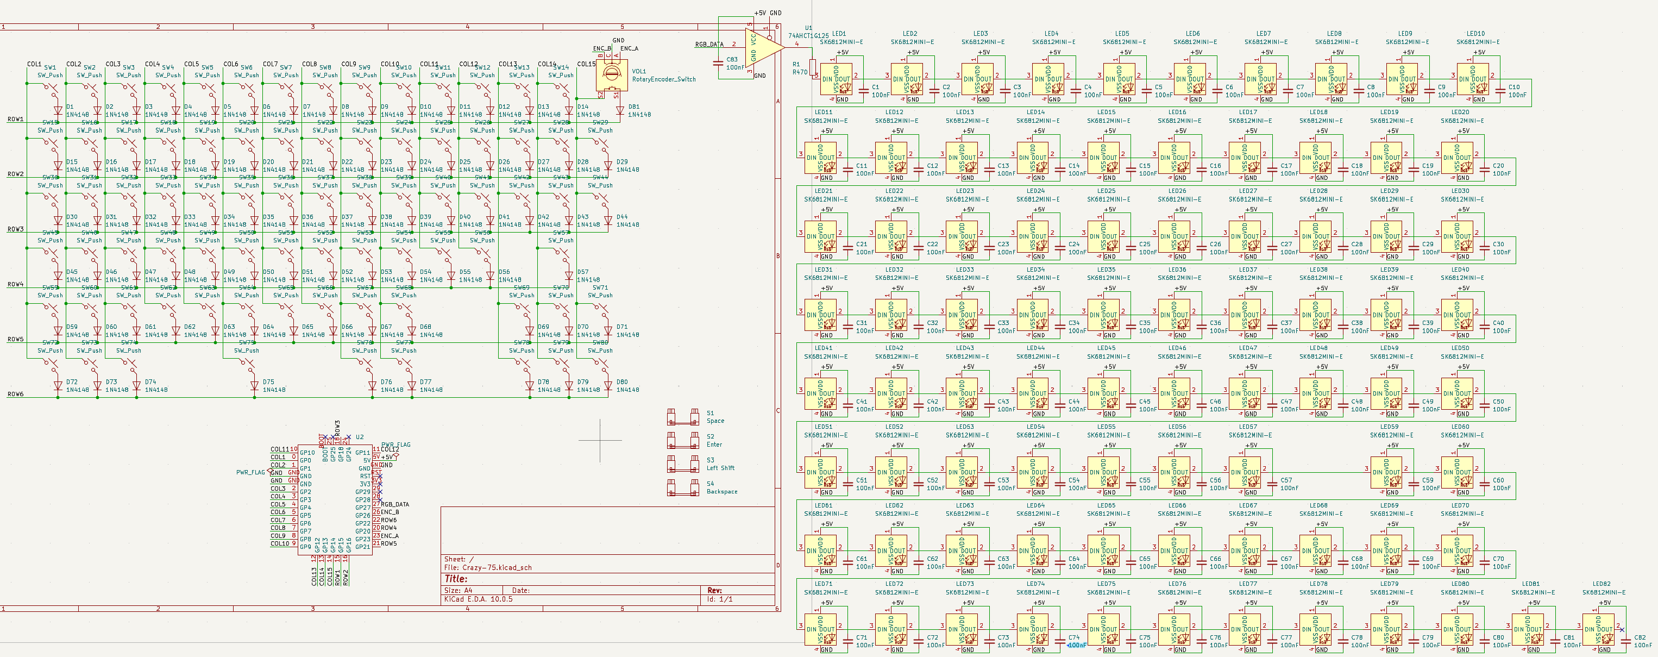
[picture p24: images/Final-schematic.png]
Finished schematic


## Final component placement

I finished placing all components on the PCB.

This included:

- switches
- hot-swap sockets
- matrix diodes
- SK6812 MINI-E LEDs
- 100 nF LED decoupling capacitors
- stabilizers
- rotary encoder
- RP2040 Pro Micro controller
- SN74AHCT1G125 level shifter
- associated resistor/capacitor components
- two additional LED + capacitor sets

The two additional LEDs were added to improve lighting on the larger keys, especially where a single LED would otherwise leave the key unevenly illuminated.

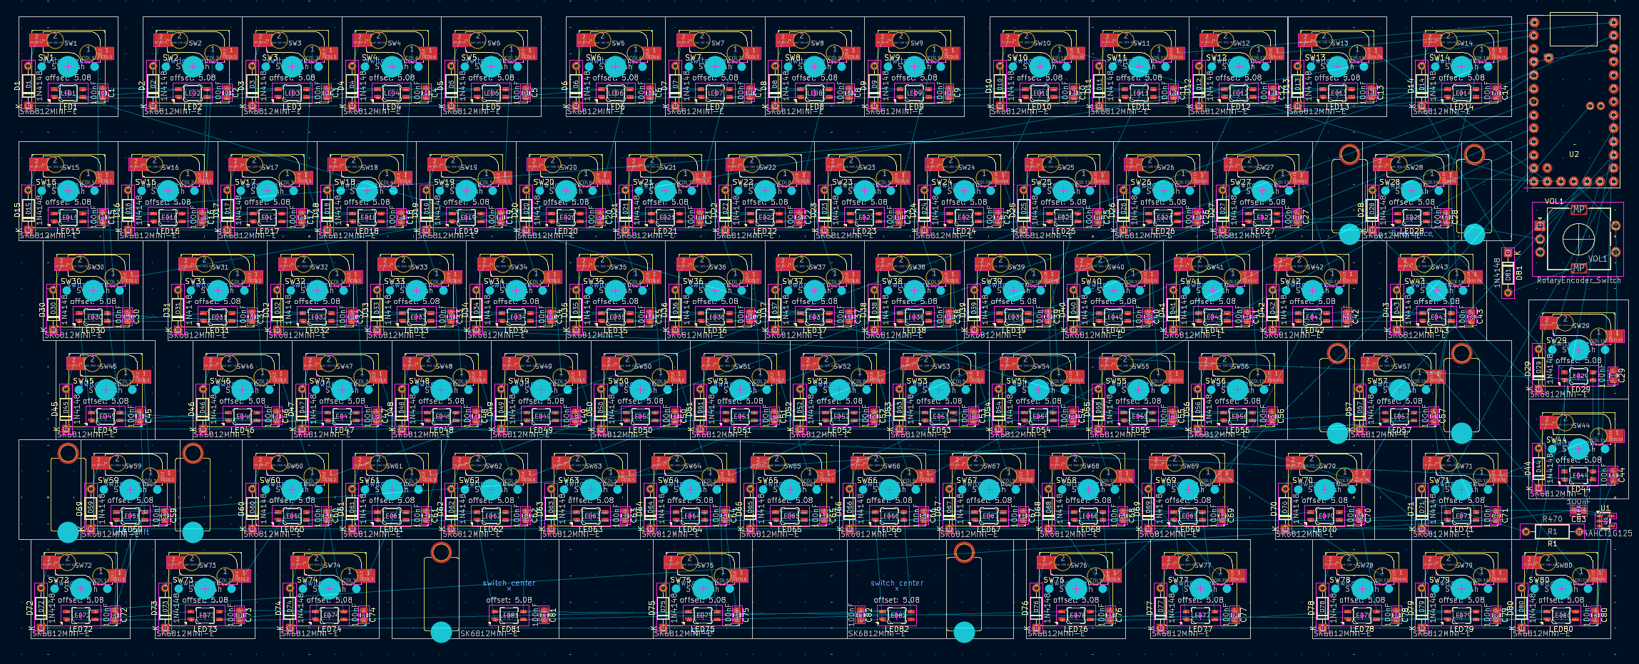
[picture p25: images/Finished-component-placement.png]
Finished PCB component placement


## Decoupling capacitor placement lesson

While checking the final placement, especially around stabilizers and other tight areas, I noticed an important issue with the LED decoupling capacitors.

Because +5 V and GND are global nets, KiCad does not electrically associate a particular capacitor with a particular LED. From the schematic's perspective, every point on +5 V is the same net and every point on GND is the same net.

Therefore, the **physical PCB placement** of the decoupling capacitor matters. Each capacitor should be positioned close to its corresponding LED's VDD and VSS pads so that the final routed connection between the capacitor and LED is short.

I adjusted the automatic placement offsets in the python code accordingly.

The final capacitor placement relative to its switch is:

```python
CAP_DX = 6.58
CAP_DY = 5.00
CAP_ROT = -90
```

This replaces the previous capacitor offset used by my placement script.

The Python placement script from the previous work session therefore remains useful, but the capacitor offsets were updated to reflect the improved physical layout.

## Placement checks and manual adjustments

After finding the new optimal capacitor placement, the Python script handled most of the repetitive placement work, but I manually checked areas where the standard key-cell arrangement could cause problems.

This included:

- stabilizer areas
- larger keys
- the bottom row
- arrow/navigation area
- controller area
- rotary encoder area

Components were moved manually where necessary rather than forcing every key to use exactly the same arrangement.

This reinforced that scripting is very useful for establishing a consistent starting layout, but unusual keys still need manual PCB-layout checks.

## BOM updates

The BOM was updated with:

- **TENSTAR RP2040 Pro Micro Development Board, 16 MB**
- a tweezer set containing:
    - one straight fine-tip tweezer
    - one curved fine-tip tweezer

The tweezers are needed for handling the small components during assembly, especially SMD.

## Current status

The schematic is now finished and the PCB has all of its components placed.

The basic physical layout is therefore largely established. The remaining work is mainly turning the ratsnest into an actual manufacturable PCB.

### Next steps

1. Define/finalize the PCB outline.
2. Plan the +5 V and GND distribution for the RGB LEDs.
3. Route the keyboard matrix.
4. Route the remaining controller and encoder signals.
5. Add appropriate power/ground copper pours.
6. Run DRC and fix routing/clearance problems.
7. Inspect the final board in the 3D viewer.
8. Prepare manufacturing files once the PCB passes the checks.

---

# 8 September 2026 - Final Schematic Checks and PCB Component Placement

**Time spent: ~2h40**

Today I finished checking the schematic and made significant progress on the physical PCB layout.

I first ran KiCad's Electrical Rules Checker (ERC). This exposed several small issues left over from earlier schematic changes, including unused Pico pins, the unused DOUT of the final RGB LED, and a typo in the `RGB_DATA` net. I added no-connect flags to intentionally unused pins and corrected the RGB data label.

The remaining ERC warning was caused by the Pico symbol treating AGND and GND as power outputs even though they are intentionally connected. I excluded this false positive.

I also revisited the RGB data signal. The RP2040 outputs 3.3 V logic while the SK6812 MINI-E LEDs are powered from 5 V, so directly driving them is outside the guaranteed input voltage specification. I compared this with two other keyboard projects, `daneski13/Junco` and `lambdakb/keyboard-lk7d`, which also use level shifting between a 3.3 V MCU and 5 V addressable LEDs.

I added an SN74AHCT1G125 level shifter between GP26 and the first LED, powered from 5 V with a 100 nF decoupling capacitor. The output then passes through the existing 470 Ω resistor before reaching LED1. After this change, ERC passed with no errors.

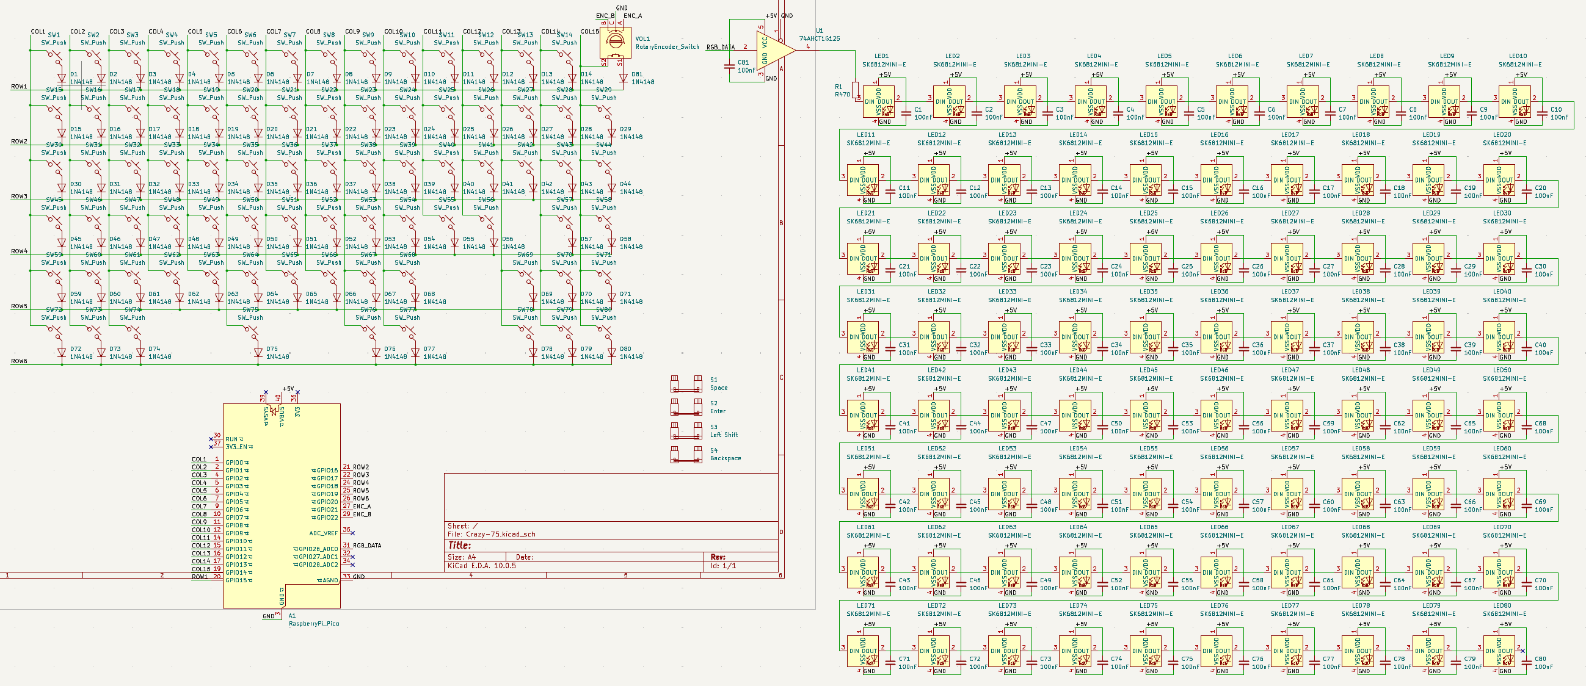
[picture p26: images/2026-09-08-final-schematic.png]
Final schematic

The picture above is the final schematic I ended up with at the end of the day. 

I then moved on to PCB placement. While checking the physical layout against my original keyboard layout, I discovered that I only had 79 MX switches instead of the required 80. One switch was missing from the Shift/Z row. I added SW80 and another diode to an unused matrix position and then corrected the component numbering so that switches and their associated components follow the physical keyboard from left to right, row by row. 

All 80 switch footprints were then placed using exact coordinates derived from the original KLE layout. I also adjusted the rotary encoder position manually because the calculated position left it farther away than I wanted.

Next I placed the four PCB-mount stabilizers for Backspace, Enter, Left Shift and the 6.25u Spacebar, centered on their respective switches.

Before placing the remaining repetitive components, I designed a standard component arrangement around one switch. For SW1 I settled on:

- LED: `(0, +5.08 mm)` relative to the switch
- 100 nF LED capacitor: `(-0.37, +10.00 mm)`, rotated 180°
- Matrix diode: `(-7.62, +7.50 mm)`, rotated 90°

I tested adjacent key cells to make sure these positions would not collide. The capacitor extends slightly into the otherwise unused space at the top of the next key cell, while still leaving enough room around the LED for tweezers during hand assembly.

Placing three components manually for every one of the 80 switches would have required hundreds of coordinate edits, so I used KiCad's Python scripting interface instead. I first tested a script on SW1 which found the switch, LED, capacitor and diode footprints by reference and calculated their positions from the switch coordinates.

After verifying that the script reproduced my manually chosen SW1 positions exactly, I expanded it to automatically place the components for the whole keyboard.

Here is the code I used: 
```

exec('''
board = pcbnew.GetBoard()

def get_fp(ref):
    for fp in board.GetFootprints():
        if fp.GetReference() == ref:
            return fp
    raise RuntimeError(f"Footprint {ref} not found")

LED_DX = 0.00
LED_DY = 5.08

CAP_DX = -0.37
CAP_DY = 10.00
CAP_ROT = 180

DIODE_DX = -7.62
DIODE_DY = 7.50
DIODE_ROT = 90

for n in range(1, 81):
    sw = get_fp(f"SW{n}")
    led = get_fp(f"LED{n}")
    cap = get_fp(f"C{n}")
    dio = get_fp(f"D{n}")

    sx = pcbnew.ToMM(sw.GetPosition().x)
    sy = pcbnew.ToMM(sw.GetPosition().y)

    led.SetPosition(
        pcbnew.VECTOR2I_MM(
            sx + LED_DX,
            sy + LED_DY
        )
    )

    cap.SetPosition(
        pcbnew.VECTOR2I_MM(
            sx + CAP_DX,
            sy + CAP_DY
        )
    )
    cap.SetOrientationDegrees(CAP_ROT)

    dio.SetPosition(
        pcbnew.VECTOR2I_MM(
            sx + DIODE_DX,
            sy + DIODE_DY
        )
    )
    dio.SetOrientationDegrees(DIODE_ROT)

pcbnew.Refresh()

```
If you decide to use this code, make shure to first run `import pcbnew` once before running any commands using `pcbnew` like this one. 

This reduced what would have been roughly 240 repetitive footprint placements to a few seconds of automated placement followed by manual inspection and adjustment.

Some exceptions still needed manual work. I moved diodes around the stabilized keys where the standard placement conflicted with stabilizer hardware, and moved the bottom-row LED capacitors upward so they would not sit unnecessarily close to the PCB edge.

After checking the arrow cluster, stabilized keys, bottom row, navigation column and several regular key areas, the repeated component layout looks solid.

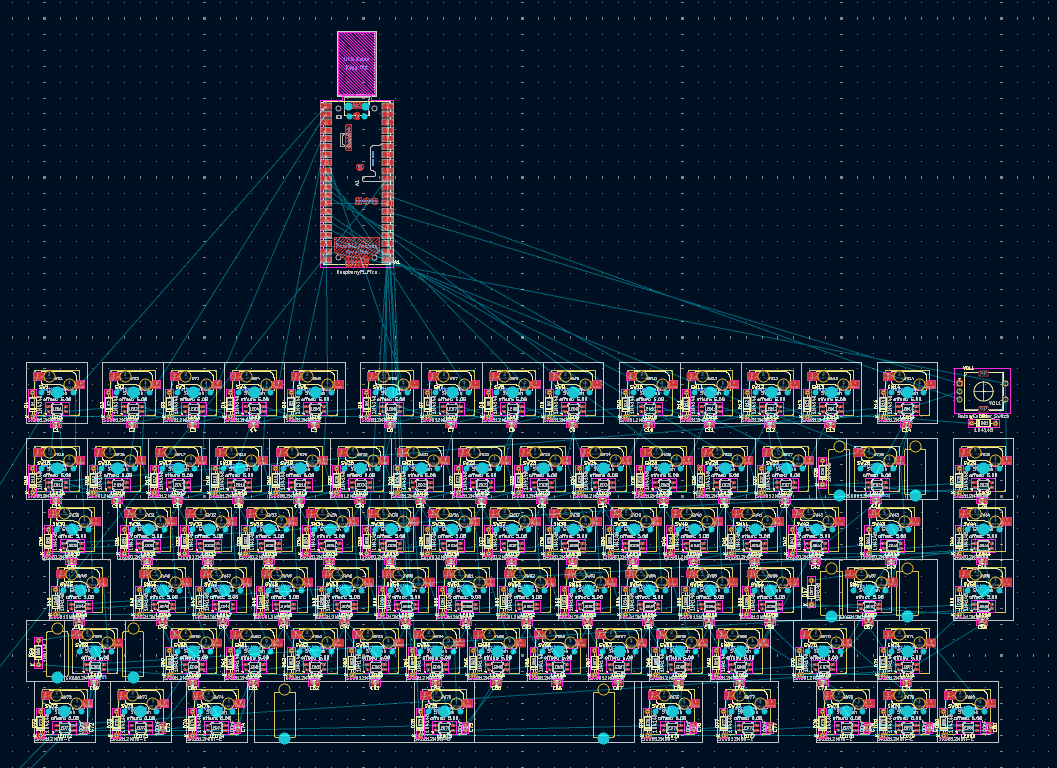
[picture p27: images/2026-09-08-key-component-placement.png]
PCB component placement


One issue I noticed is the Spacebar lighting. The 6.25u Spacebar currently has only one RGB LED in its center, which will probably produce noticeably uneven lighting compared with the rest of the keyboard. I will revisit this later and likely add additional LEDs underneath the Spacebar.

### Next steps

- Find a suitable position for the large Raspberry Pi Pico module while keeping its USB-C port accessible from the case.
- Place the RGB level shifter and its decoupling capacitor.
- Check remaining mechanical/component clearances.
- Decide how to improve Spacebar lighting.
- Continue PCB layout and begin planning the routing once component placement is finalized.

---

# 6 September 2026 - Finishing the Schematic and Correcting Footprints

**Time spent: ~2h 30min**

### Returning to the schematic

After returning from vacation, I continued working on the Crazy-75 schematic.

I first connected the Raspberry Pi Pico-compatible RP2040 controller to the keyboard matrix. The current matrix uses 6 rows and 15 columns, so I assigned the GPIOs as follows:

- GP0–GP14 → COL1–COL15
- GP15–GP20 → ROW1–ROW6
- GP21 → rotary encoder A
- GP22 → rotary encoder B
- GP26 → RGB data
- GP27 and GP28 remain unused

The rotary encoder push switch is part of the keyboard matrix, so it does not require another dedicated GPIO.

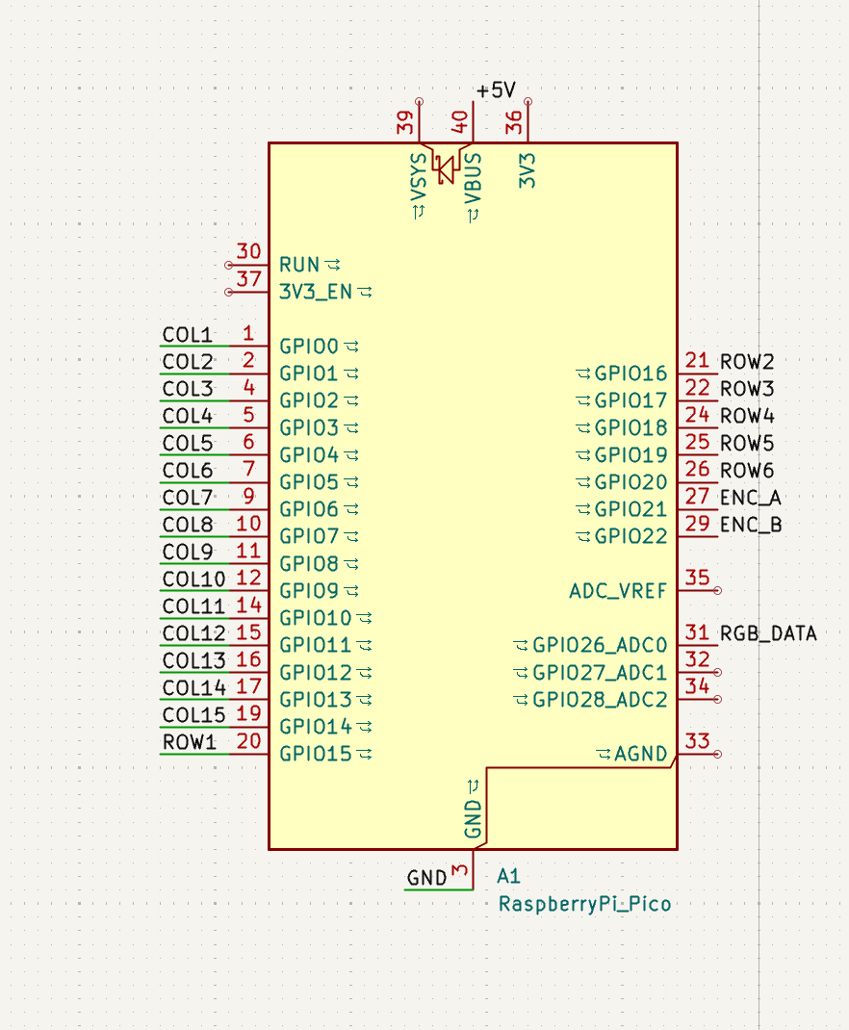
[picture p28: images/2026-09-06-pico-matrix.png]
Pico and keyboard matrix


### Pico power and USB

I checked the pinout of the RP2040 Pico-compatible board I selected for the project. It exposes the standard 26 GPIO pins and has SWD debug pads, but does not expose USB D+ and D- separately.

Because of this, using a separate USB-C connector on the keyboard PCB would add unnecessary complexity. I decided to use the USB-C connector already present on the Pico-compatible board despite power-draw concerns caused by the 80 LEDs. 

The +5 V rail for the RGB LEDs is connected to VBUS. I also connected AGND to GND.

The RGB brightness will need to be limited in firmware because 80 SK6812 MINI-E LEDs could draw far too much current if all LEDs were driven at maximum brightness.

### Comparing the design with another KEEB keyboard

I looked through the Tap65 project, another custom keyboard funded through Hack Club KEEB, to compare its design with mine.

This turned out to be very useful. The project made me realise that I had used generic switch symbols/footprints rather than footprints intended for the Kailh hot-swap sockets I plan to use.

It also highlighted how important it is to verify the SK6812 MINI-E pinout and footprint before manufacturing, since an incorrect LED footprint/pin mapping can make the RGB chain unusable.

### Installing marbastlib

I went back to the ebastler KiCad repository to install the keyboard-specific library.

At first I accidentally installed the **Connect-traces** plugin. When I still could not find the keyboard symbols and footprints I was looking for, I realised that I actually needed to install the **marbastlib** library separately.

After installing marbastlib, the correct keyboard-specific symbols and footprints became available.

### Correcting the switch footprints

I replaced the existing switch setup with the marbastlib Kailh hot-swap MX footprints for CPG151101S11 sockets.

Changing the switch symbols caused the existing electrical connections to be lost, so I had to reconnect the switches to the matrix and their diodes.

This took some extra work, but the schematic now matches the type of hot-swap sockets that will actually be used on the PCB.

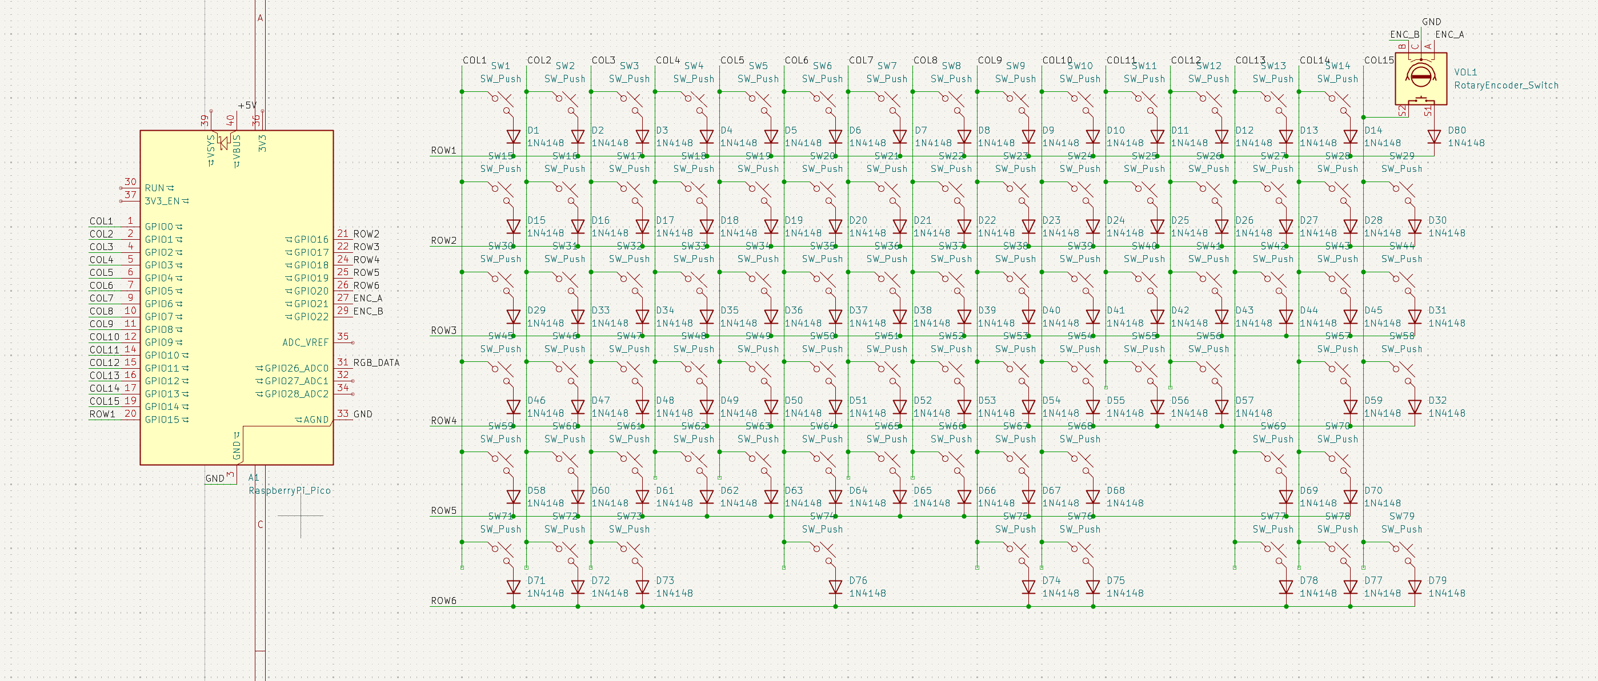
[picture p29: images/2026-09-06-hotswap-matrix.png]
Corrected hot-swap matrix


### Verifying the RGB LEDs

I also changed/verified the SK6812 MINI-E setup using the marbastlib resources.

The RGB system currently consists of:

- 80 × SK6812 MINI-E LEDs
- 80 × 100 nF decoupling capacitors
- one 470 Ω resistor before the first LED
- +5 V and GND distribution
- a daisy chain from DOUT of each LED to DIN of the next LED
- RGB_DATA from GP26

The LED symbols did not visibly change when changing them, but the correct library resources and footprints are now assigned.

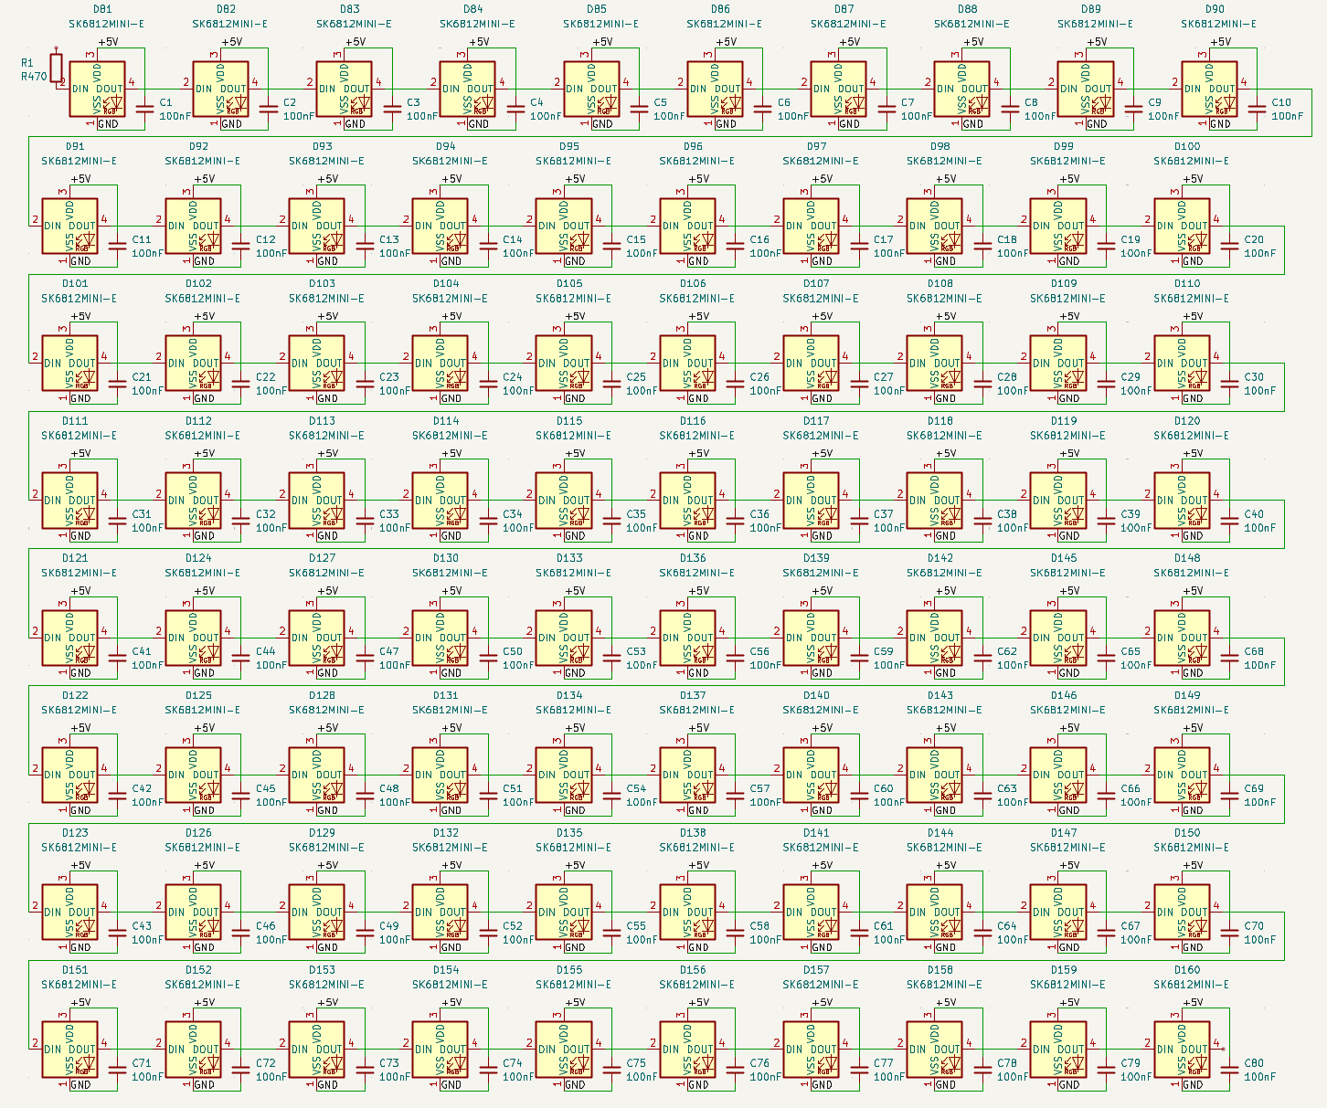
[picture p30: images/2026-09-06-rgb-chain.png]
SK6812 MINI-E chain


### Rotary encoder

I verified the previously selected EC11 rotary encoder and assigned its footprint.

The encoder will control volume, with its push button intended for mute/unmute.

Its rotation pins use GP21 and GP22, while the push button is connected through the keyboard matrix.

### Stabilizers

I found a cheaper set of well-reviewed PCB-mount screw-in stabilizers and updated the BOM.

The layout requires stabilizers for:

- Backspace
- Enter
- Left Shift
- 6.25u Spacebar

I added the corresponding stabilizer footprints to the schematic. Since stabilizers are purely mechanical, they do not require electrical connections.

I also investigated lubricating the stabilizers. GPL205 is available in 10 g jars for around €10. This is much more lubricant than one keyboard needs, so I have not decided yet whether it is worth including in the funded BOM or buying separately.

### BOM updates

I updated the BOM with the newly selected screw-in stabilizers and the other component decisions made today.

At this point, every component in the schematic has a footprint assigned and all electrical components are connected.

### Current schematic

The schematic is now much closer to being ready for PCB layout.

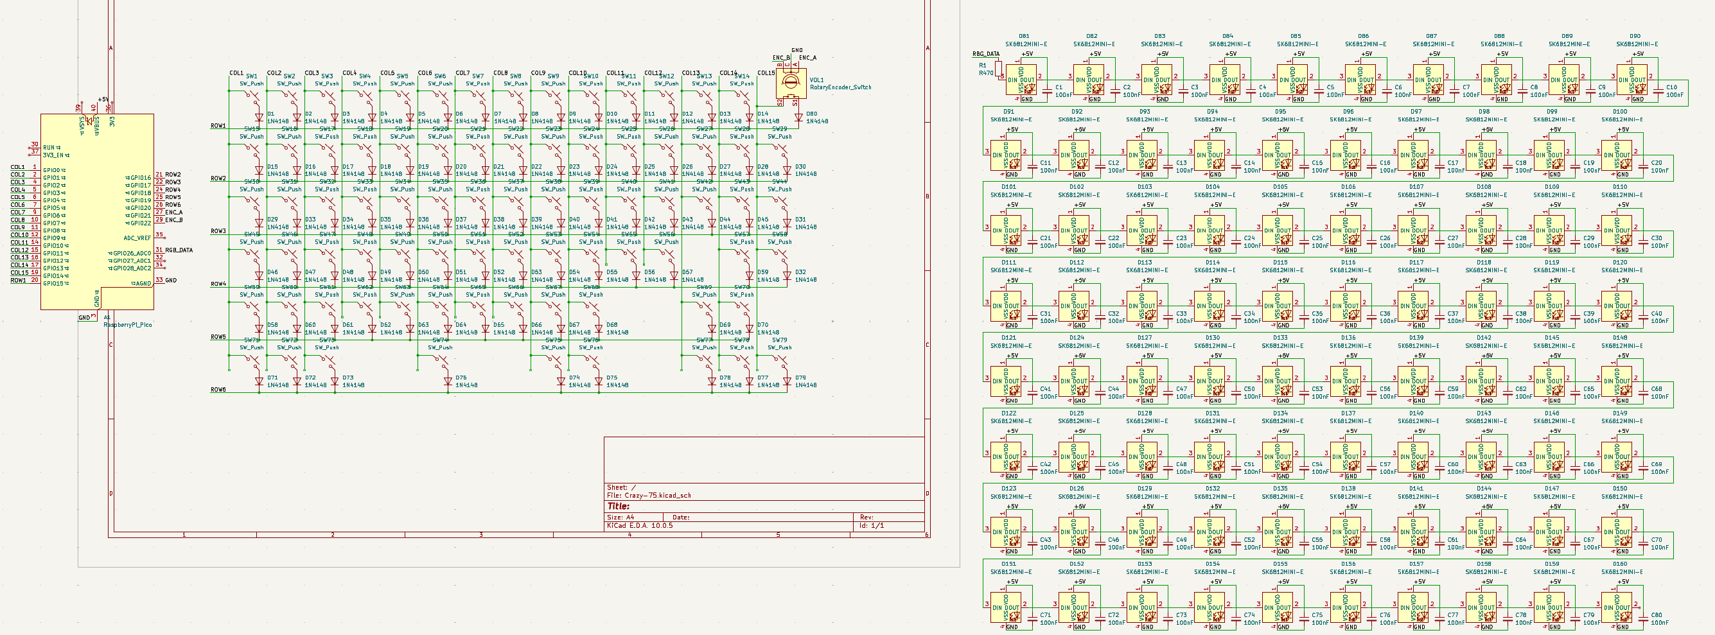
[picture p31: images/2026-09-06-complete-schematic.png]
Crazy-75 schematic at end of day


### Next steps

- Run KiCad ERC and investigate any warnings/errors
- Do a final check of component pinouts and footprints
- Transfer the schematic to PCB Editor
- Import/recreate the physical keyboard layout
- Determine the best location and orientation for the Pico module
- Place stabilizers, hot-swap sockets, LEDs, diodes and capacitors
- Begin PCB routing

---

# 27 August 2026 - Starting the PCB Schematic

**Time spent: ~1h 10min**

### Starting the schematic

Today I started designing the keyboard PCB in KiCad.

I began by adding the first rows of keyboard switches, their 1N4148 diodes, and the EC11 rotary encoder to the schematic.

Initially, I arranged the switches roughly according to their physical positions based on my design from yesterday. This made sense to me at first because it made the schematic resemble the actual keyboard layout.

**Initial schematic layout:**

Initial schematic layout

After looking more closely at the KEEB guide, I realized that the schematic does not need to represent the physical position of the components. Its purpose is to clearly describe how the components are electrically connected.

I therefore reorganized the switches into a grid representing the keyboard matrix. This makes the rows and columns much easier to see and should make connecting the matrix to the microcontroller easier later.

### Keyboard matrix

I currently have the 80 switches organized into **6 rows and 15 columns**, with one 1N4148 diode for every switch.

I connected the switches into their respective rows and columns and kept unused matrix positions empty where the physical keyboard does not have a key.

I also added the EC11 rotary encoder to the schematic. It will eventually be used for volume control, with the integrated push button planned for mute/unmute.

**Current schematic:**

Keyboard matrix schematic1

Fun fact about me: I never listen to music while working because I find it distracting.
### Next steps

- Check the matrix for incorrect or missing connections
    
- Add the Raspberry Pi Pico-compatible RP2040 controller
    
- Assign GPIO pins to the matrix rows and columns
    
- Connect the rotary encoder
    
- Add the SK6812 MINI-E RGB circuit
    
- Continue following the KEEB schematic design guide

---

# 26 August 2026 - Specification and Layout
**Time spent: ~1 hour**

### What I did

Today I finalized the main specifications for the keyboard and created the first version of the physical layout.

I also cleaned up the GitHub repository by adding `.obsidian/` to `.gitignore`. This keeps my local Obsidian configuration out of the public repository while still allowing me to use Obsidian to write the project documentation.

### Finalized specifications

- Approximately 75% layout
    
- ANSI physical layout
    
- US QWERTY
    
- Dedicated F1–F12 keys
    
- Dedicated arrow keys
    
- Dedicated `Delete`, `Home` and `End`
    
- One programmable `M1` key
    
- Rotary encoder for volume control and mute
    
- MX 5-pin switch support
    
- Hot-swappable switches
    
- Per-key RGB using `SK6812 MINI-E` LEDs
    
- 3D-printed case
    
- Internal dampening

### Keyboard layout

I designed the physical layout using Keyboard Layout Editor. I used a conventional 75% keyboard as a starting point but removed keys I don't expect to use, such as `Page Up` and `Page Down`.

I kept `Home` and `End` because I expect them to be useful for navigating text and code. The remaining position in the navigation column became an `M1` key whose function will be decided later.

The rotary encoder is located in the top-right corner and is currently planned to control volume, with pressing the encoder muting/unmuting the computer.

This keyboard layout contains 80 MX style switches + the rotary encoder. 

**Final layout:**

keyboard-layout

The editable Keyboard Layout Editor data is stored at:

`Layout/keyboard-layout.json`

### Next steps

- Finish the BOM
- Begin work in KiCad

### Initial BOM and component sourcing

**Time spent: ~1 hour**

Continued completing the BOM.

I found candidates for:
- Stabilizers
- 1N4148 through-hole diodes
- SK6812 MINI-E RGB LEDs
- EC11 rotary encoder
- RP2040 Raspberry Pi Pico-compatible controller

I compared several RP2040 boards And ultimately landed on one with the same dimensions and pinout as a classic RP2040 Pi pico to avoid complications in the future. 

I recorded quantities, prices before checkout and purchase links in the BOM.

The remaining major parts to source include switches and keycaps as well as the dampening material, but these can wait while I design the PCB.

### Next step
- Begin work in KiCad

---

# 25 August 2026

**Time spent: 1h**

### What I did

Started planning my keyboard and decided on the main
requirements.

### Decisions

- 75% layout
- ANSI
- US QWERTY
- MX 5-pin switches
- Kailh hot-swap sockets
- Per-key RGB using `SK6812 MINI-E`
- 3D-printed case

### Hot-swap socket research

I looked at several options and selected...

Socket listing

### Problems / things to investigate

- [ ] Decide mounting system

### Next steps

Finalize the exact key layout and begin the schematic.

**Repository setup - 45 min**  
Created the GitHub repository for the project and set it up as an Obsidian vault. Created the initial README and development journal, configured standard Markdown links for GitHub compatibility, and organized the repository for future PCB, CAD and image files.

---
