CrazyWizard-png/Crazy-75__Custom-Mechanical-Keyboard/(commit log)

2026-09-06 06.09.2026 Log
    [Crazy-75.kicad_sch, Keyboard BOM.xlsx]
2026-09-06 Small schematics update
    [Crazy-75.kicad_sch]
2026-09-08 08.09.2026: PCB work
    [Crazy-75.kicad_pcb, Crazy-75.kicad_sch, Keyboard BOM.xlsx]
2026-09-11 11.09.2026 - PCB design and schematics changes
    [Crazy-75.kicad_pcb, Crazy-75.kicad_sch, Keyboard BOM.xlsx]
2026-09-13 13.09.2026 - PCB Mechanical Checks & 3D Validation
    Continued working on the physical PCB layout and checking whether the component arrangement would actually work mechanically.
    [Crazy-75.kicad_pcb, Crazy-75.kicad_sch, Keyboard BOM.xlsx]
2026-09-14 14.09.2026 - Finalizing PCB 3D model
    [Crazy-75.kicad_pcb]
2026-09-26 24+26.09.2026 - Plate design
    [Crazy-75 - PCB.step, Crazy-75.kicad_pcb, Keyboard BOM.xlsx, crazy75_switch_positions.csv]
2026-10-01 # 1 October 2026 - Starting the top case
    [Crazy-75 - PCB.step, Crazy-75.kicad_pcb, Keyboard BOM.xlsx]
2026-10-10 10.10.2026 - Back to the PCB
2026-10-24 24.10.2026 - PCB redesign
2026-10-31 31.10.2026 - PCB component placement & Cleaning up the BOM
2026-11-01 01.11.2026 - Case CAD model update
